zandmd/esp32-projects/eda/3d/PASSIVE-NPOL-0805.stp

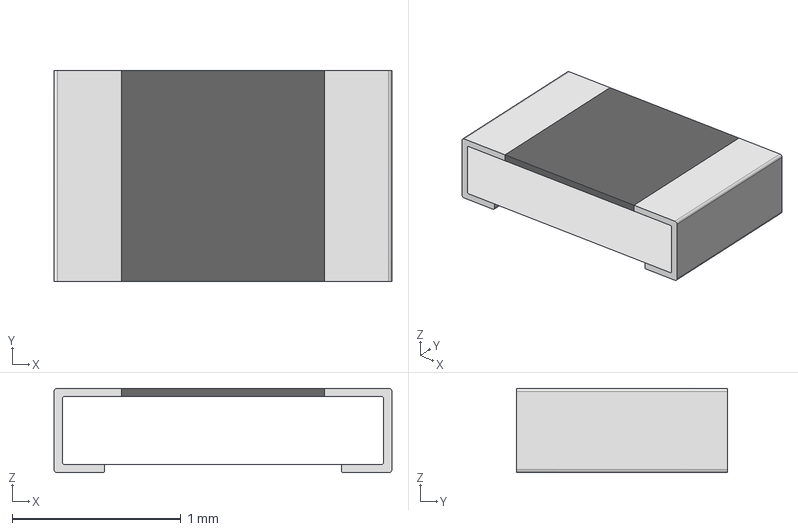
[picture p1: CAD file, 2023-10-10]
eda/3d/PASSIVE-NPOL-0805.stp
2.00 x 1.25 x 0.5 mm
