zandmd/esp32-projects/eda/3d/302-S101.step

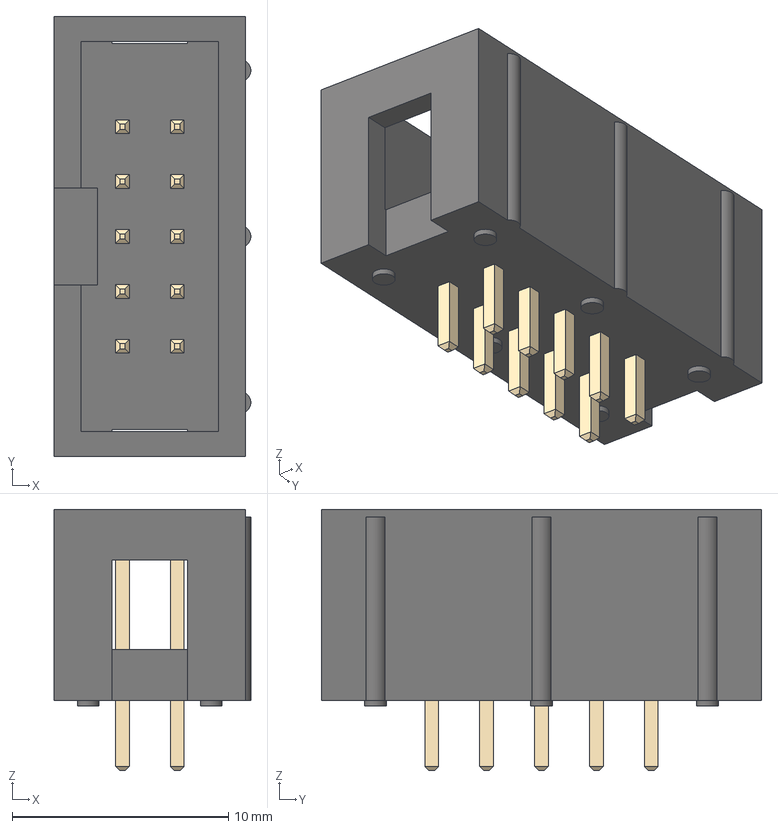
[picture p3: CAD file, 2023-10-10]
eda/3d/302-S101.step
9.10 x 20.4 x 12.1 mm
