zandmd/esp32-projects/eda/3d/3586KTR.step

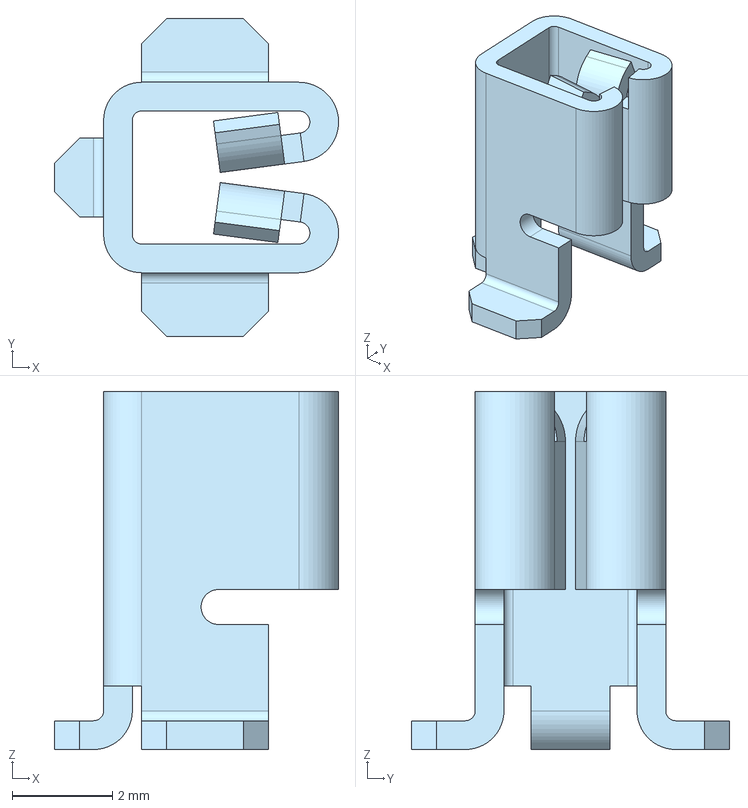
[picture p4: CAD file, 2023-10-10]
eda/3d/3586KTR.step
5.68 x 6.35 x 7.16 mm
