zandmd/esp32-projects/eda/3d/AZ1117IH-3.3TRG1.step

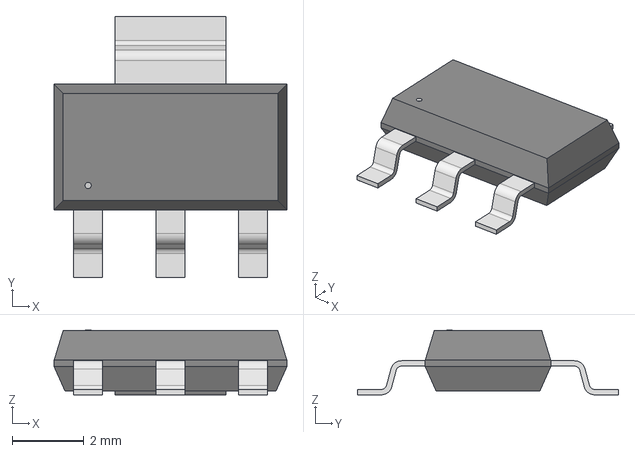
[picture p5: CAD file, 2023-10-10]
eda/3d/AZ1117IH-3.3TRG1.step
6.50 x 7.29 x 1.81 mm
