zandmd/esp32-projects/eda/3d/AZ1084CS2-3.3TRE1.step

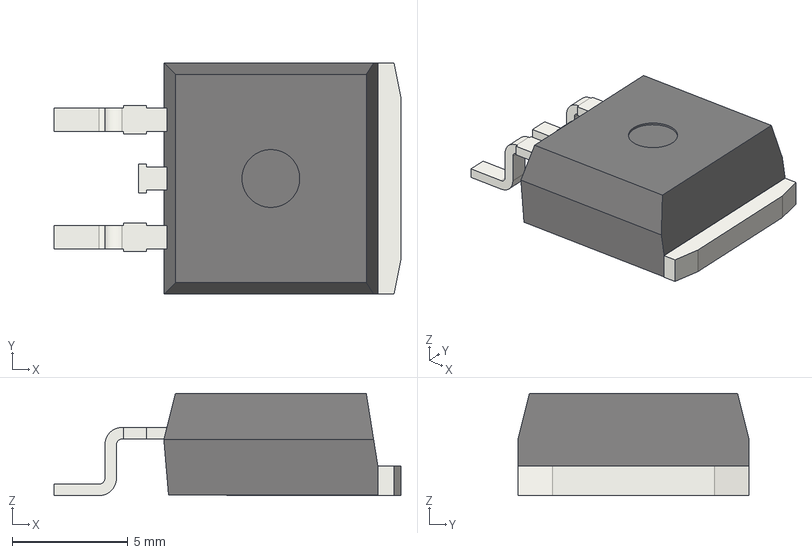
[picture p6: CAD file, 2023-10-10]
eda/3d/AZ1084CS2-3.3TRE1.step
15.0 x 10.0 x 4.42 mm
a3dd6ad7-9c39-11ed-93f0-dde97e994e83_part
a3dd6ad8-9c39-11ed-93f0-dde97e994e83_part
a3dd6ad9-9c39-11ed-93f0-dde97e994e83_part
