zandmd/esp32-projects/eda/3d/LSM6DSOTR.step

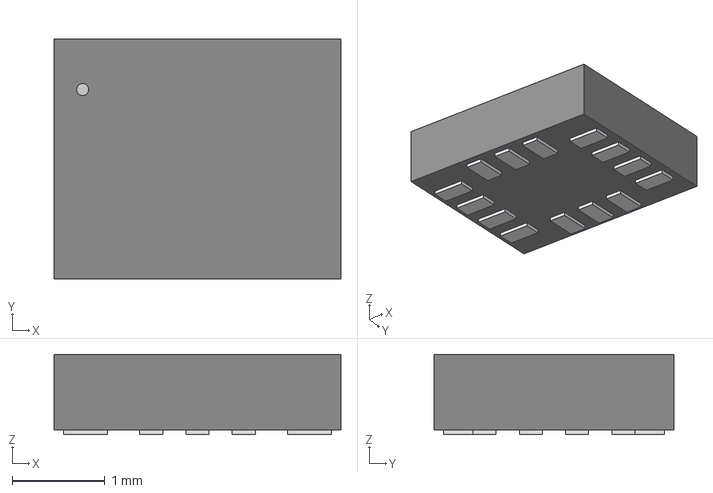
[picture p8: CAD file, 2023-10-10]
eda/3d/LSM6DSOTR.step
3.10 x 2.59 x 0.866 mm
