zandmd/esp32-projects/eda/3d/PASSIVE-NPOL-1206.stp

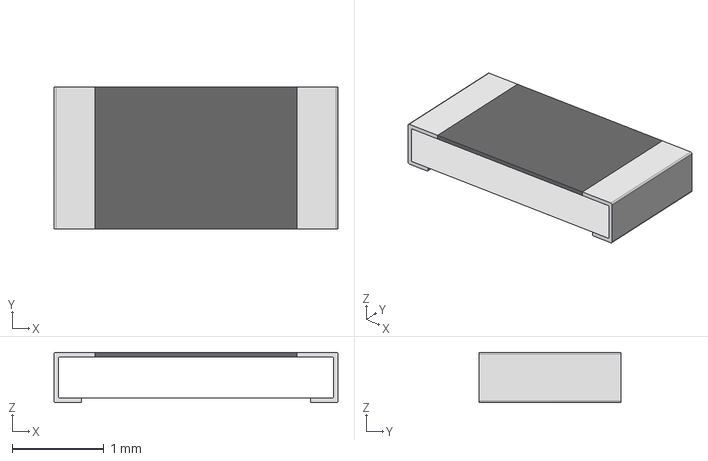
[picture p9: CAD file, 2023-10-10]
eda/3d/PASSIVE-NPOL-1206.stp
3.10 x 1.55 x 0.55 mm
