zandmd/esp32-projects/eda/3d/SMAJ5.0A.step

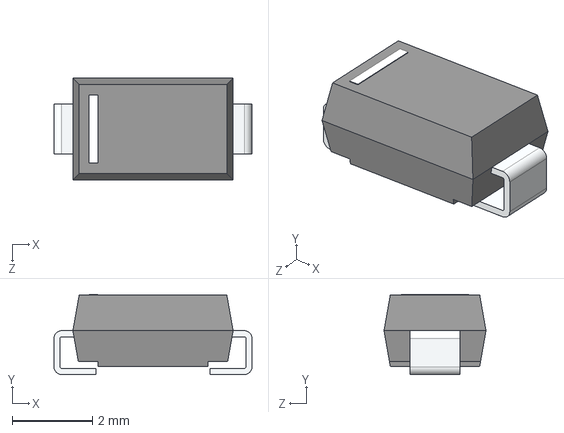
[picture p10: CAD file, 2023-10-10]
eda/3d/SMAJ5.0A.step
4.93 x 1.99 x 2.54 mm
