zandmd/esp32-projects/eda/3d/PASSIVE-POL-LED-5.7MM.stp

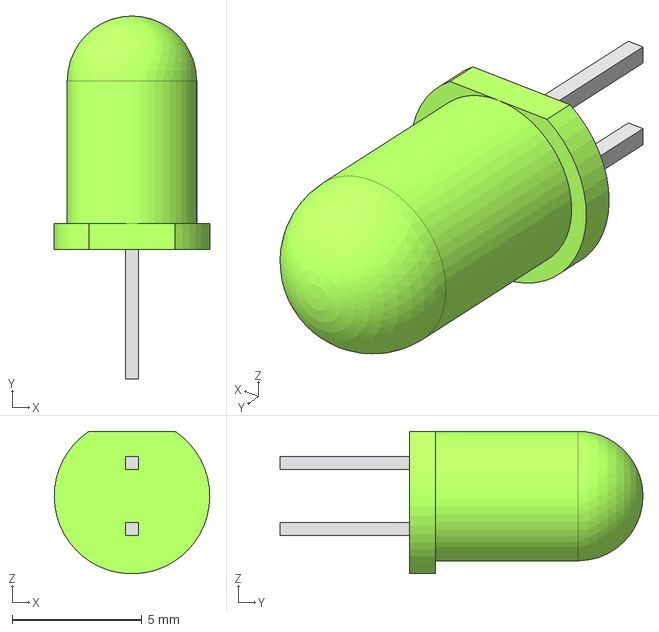
[picture p11: CAD file, 2023-10-10]
eda/3d/PASSIVE-POL-LED-5.7MM.stp
6.00 x 14.0 x 5.49 mm
