zandmd/esp32-projects/eda/3d/SHT40-BD1B-R3.STEP

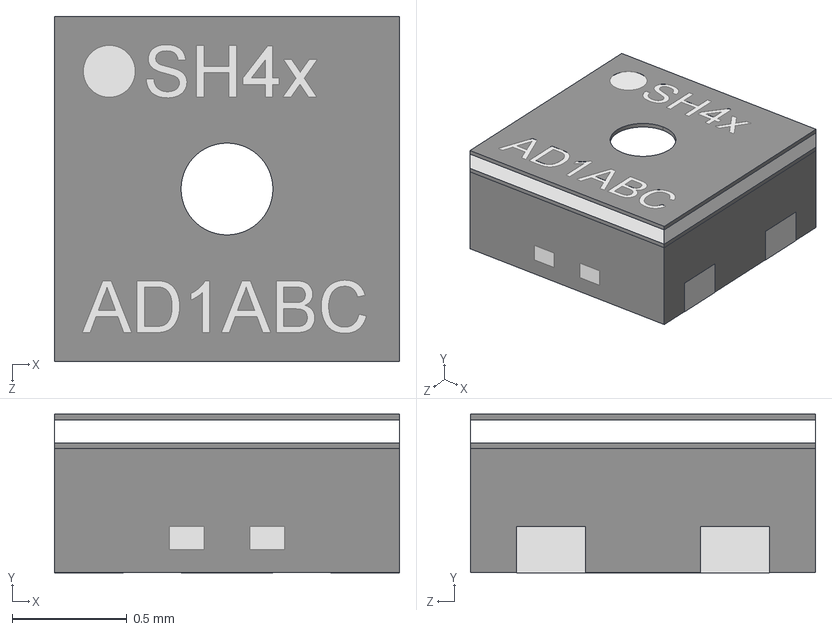
[picture p12: CAD file, 2023-10-10]
eda/3d/SHT40-BD1B-R3.STEP
1.50 x 0.691 x 1.50 mm
