zandmd/esp32-projects/eda/3d/LTV-847S.STEP

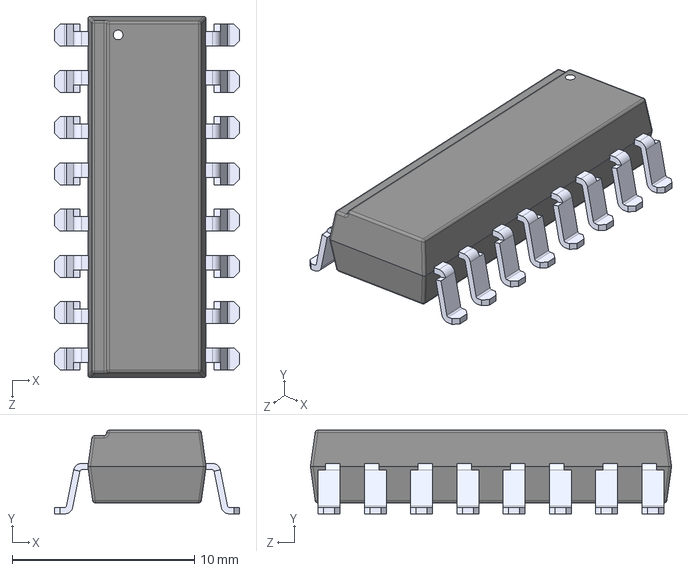
[picture p13: CAD file, 2023-10-10]
eda/3d/LTV-847S.STEP
10.2 x 4.60 x 19.8 mm
