zandmd/esp32-projects/eda/3d/PTS645SM43SMTR92 LFS.STEP

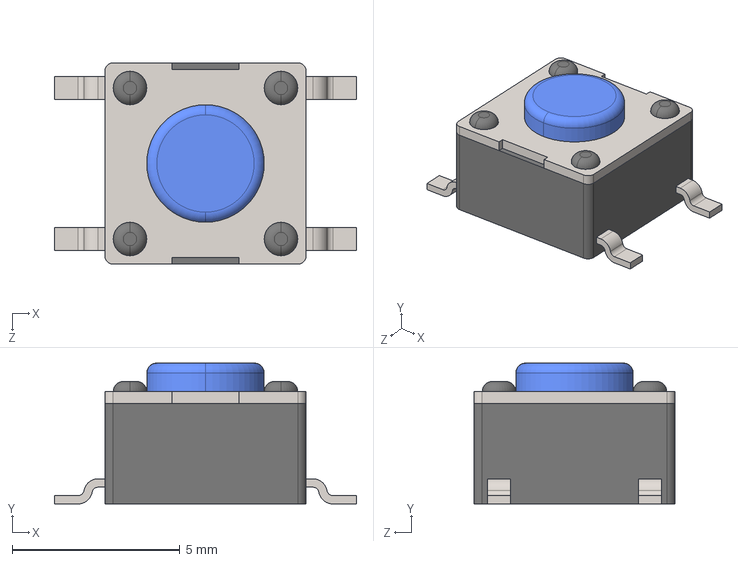
[picture p14: CAD file, 2023-10-10]
eda/3d/PTS645SM43SMTR92 LFS.STEP
9.00 x 4.20 x 6.00 mm
