zandmd/esp32-projects/eda/3d/BSS816NWH6327XTSA1.step

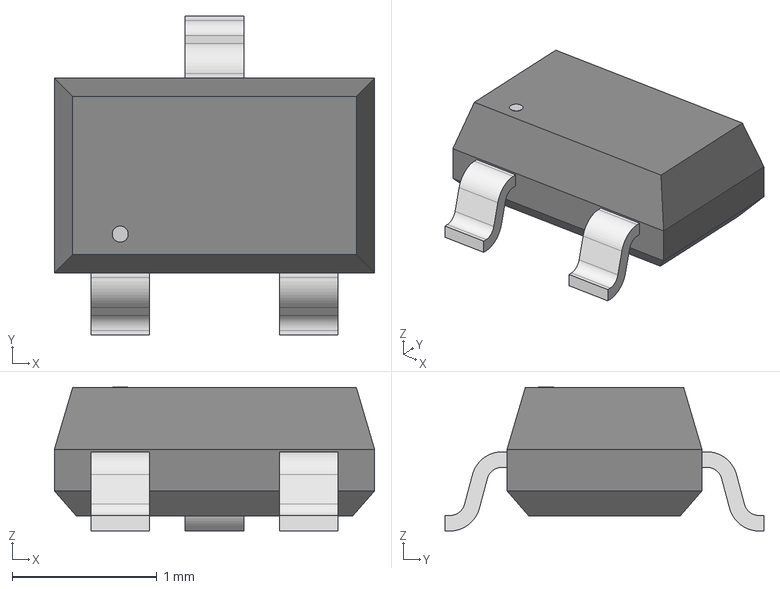
[picture p15: CAD file, 2023-10-10]
eda/3d/BSS816NWH6327XTSA1.step
2.21 x 2.20 x 0.993 mm
