zandmd/esp32-projects/eda/3d/101-106.step

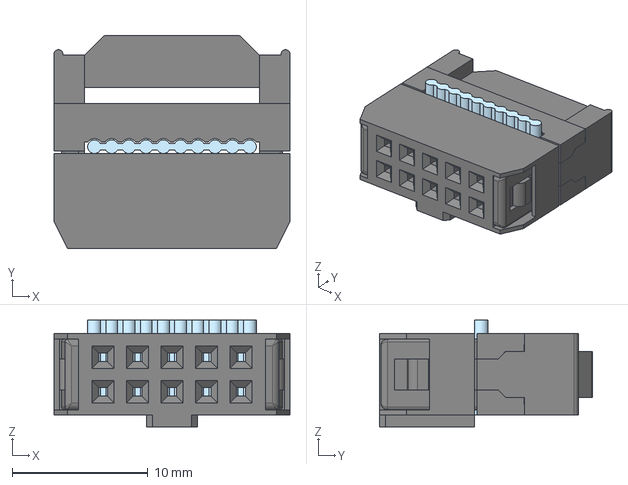
[picture p16: CAD file, 2023-10-10]
eda/3d/101-106.step
17.4 x 15.7 x 7.86 mm
