zandmd/esp32-projects/eda/3d/MB14S.STEP

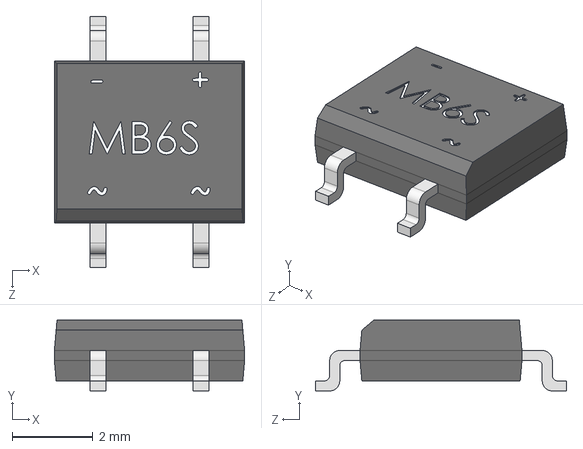
[picture p17: CAD file, 2023-10-10]
eda/3d/MB14S.STEP
4.70 x 1.75 x 6.20 mm
