zandmd/esp32-projects/eda/3d/CP2102N-A02-GQFN28.step

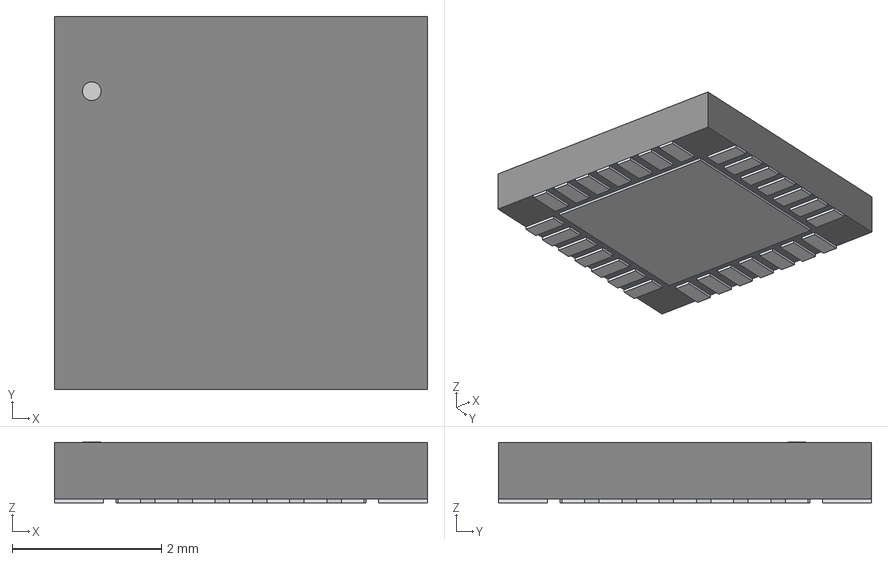
[picture p18: CAD file, 2023-10-10]
eda/3d/CP2102N-A02-GQFN28.step
5.00 x 5.00 x 0.815 mm
