zandmd/esp32-projects/eda/3d/DF3A6.8LFV,L3F.step

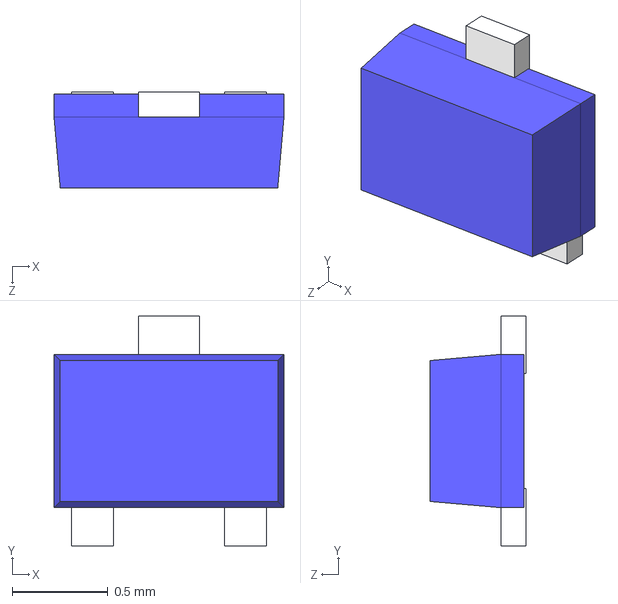
[picture p19: CAD file, 2023-10-10]
eda/3d/DF3A6.8LFV,L3F.step
1.20 x 1.20 x 0.5 mm
