zandmd/esp32-projects/eda/3d/G120N03D32.step

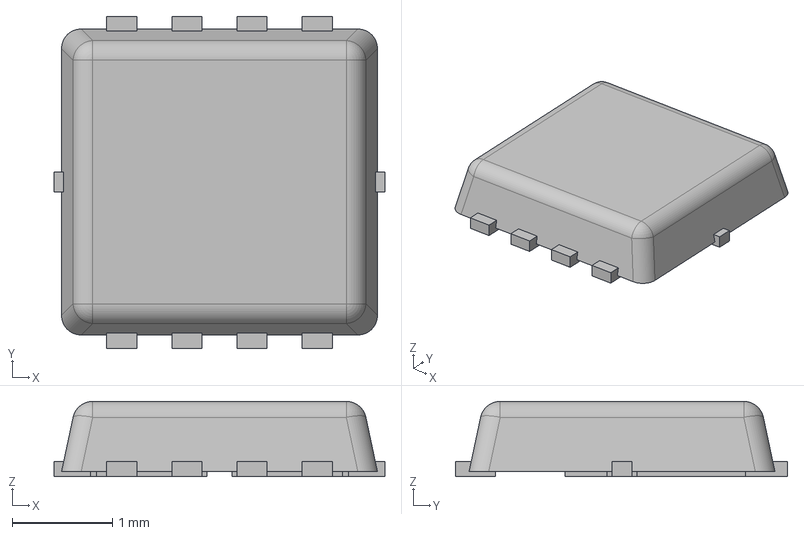
[picture p20: CAD file, 2023-10-10]
eda/3d/G120N03D32.step
3.30 x 3.31 x 0.75 mm
