zandmd/esp32-projects/eda/3d/PASSIVE-POL-LED-153283367A212.step

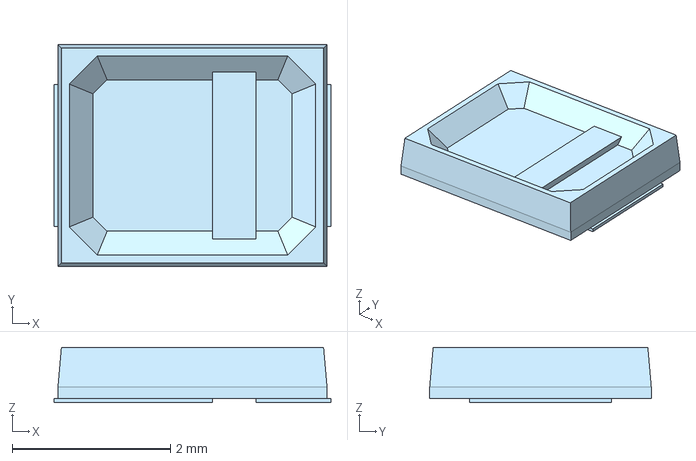
[picture p21: CAD file, 2023-10-10]
eda/3d/PASSIVE-POL-LED-153283367A212.step
3.50 x 2.80 x 0.7 mm
