zandmd/esp32-projects/eda/3d/TSOP38238.stp

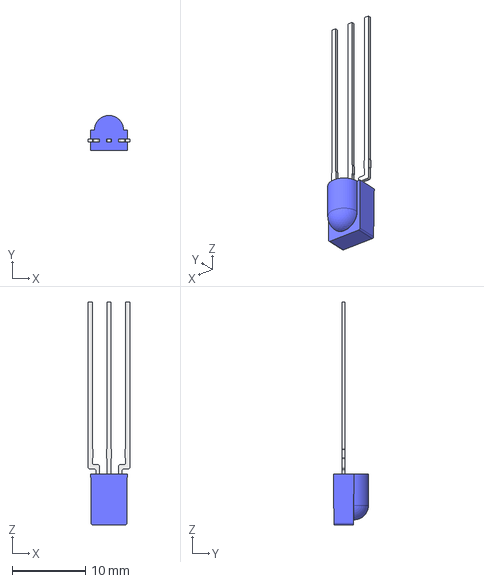
[picture p22: CAD file, 2023-10-10]
eda/3d/TSOP38238.stp
5.78 x 4.80 x 30.5 mm
GO-100187
GO-100187.01
