zandmd/esp32-projects/eda/3d/SPH0645LM4H-B.STEP

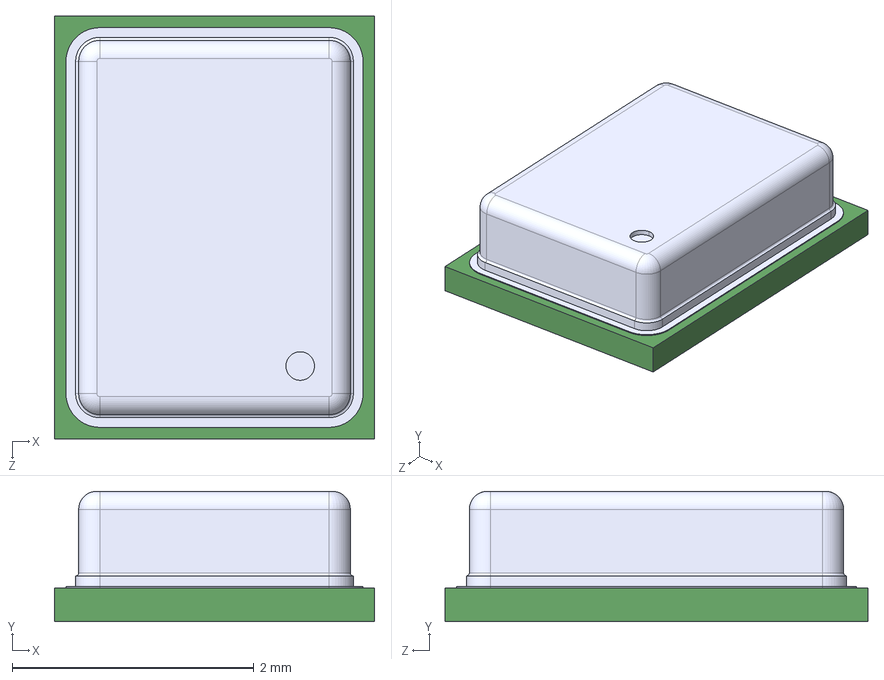
[picture p23: CAD file, 2023-10-10]
eda/3d/SPH0645LM4H-B.STEP
2.65 x 1.08 x 3.50 mm
