zandmd/esp32-projects/eda/3d/CM1293A-04SO.step

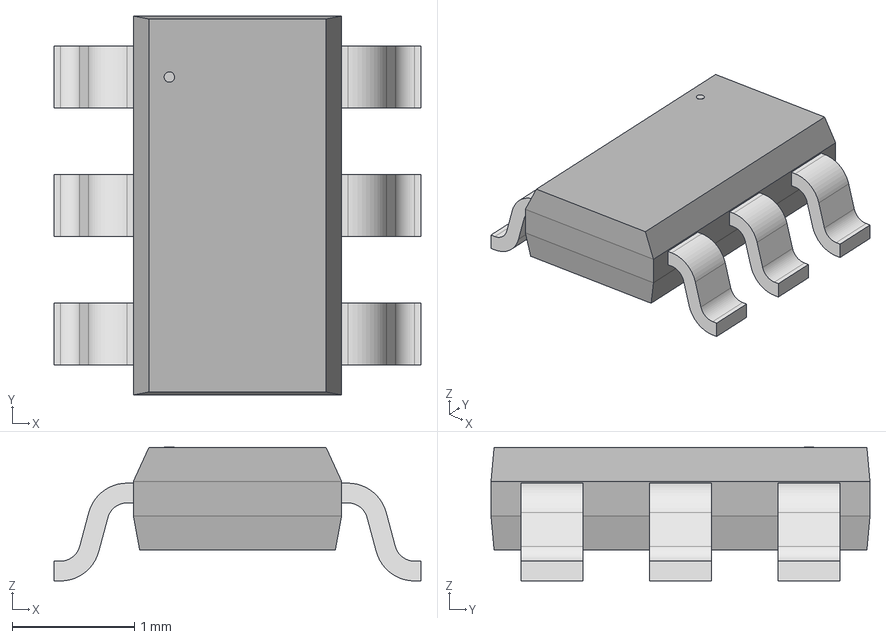
[picture p24: CAD file, 2023-10-10]
eda/3d/CM1293A-04SO.step
3.00 x 3.10 x 1.09 mm
