zandmd/esp32-projects/eda/3d/OSTVN04A150.STEP

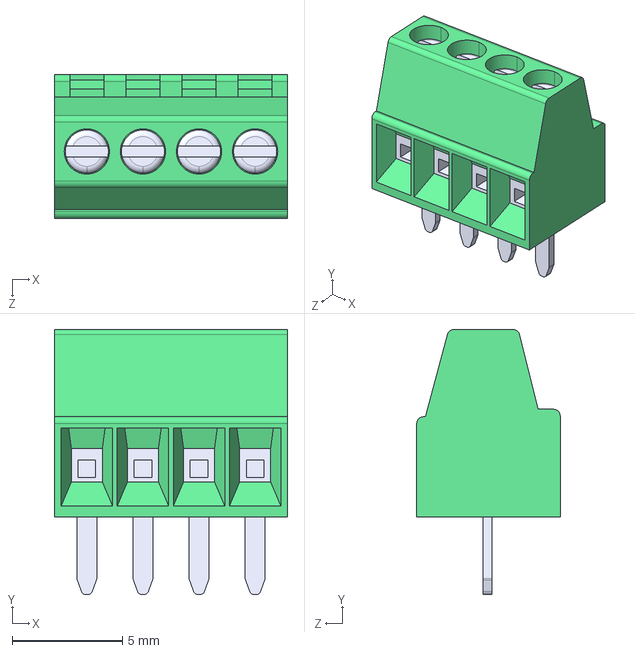
[picture p25: CAD file, 2023-10-10]
eda/3d/OSTVN04A150.STEP
10.6 x 12.0 x 6.50 mm
