zandmd/esp32-projects/eda/3d/PH1-03-UA.stp

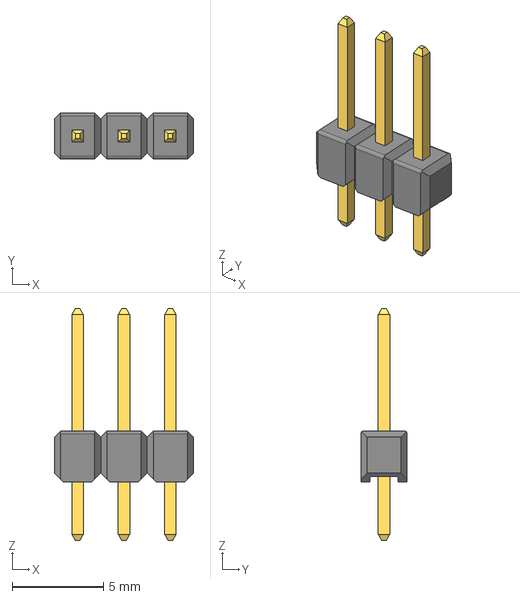
[picture p26: CAD file, 2023-10-10]
eda/3d/PH1-03-UA.stp
7.62 x 2.54 x 12.7 mm
