zandmd/esp32-projects/eda/3d/2659.STEP

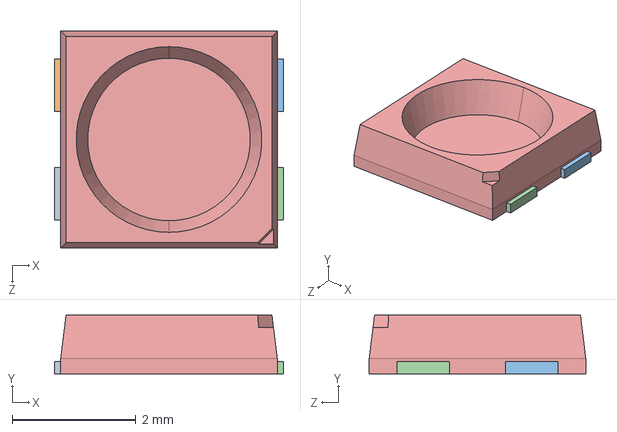
[picture p27: CAD file, 2023-10-10]
eda/3d/2659.STEP
3.70 x 0.95 x 3.50 mm
