zandmd/esp32-projects/eda/3d/AP3032KTR-G1.step

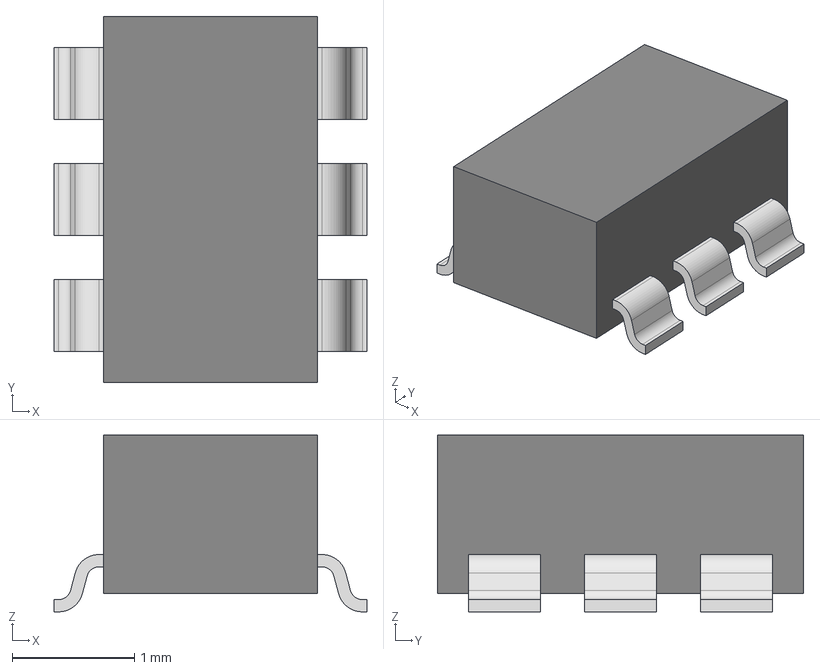
[picture p28: CAD file, 2023-10-10]
eda/3d/AP3032KTR-G1.step
2.56 x 3.00 x 1.45 mm
