zandmd/esp32-projects/eda/3d/S2B-PH-K-S.step

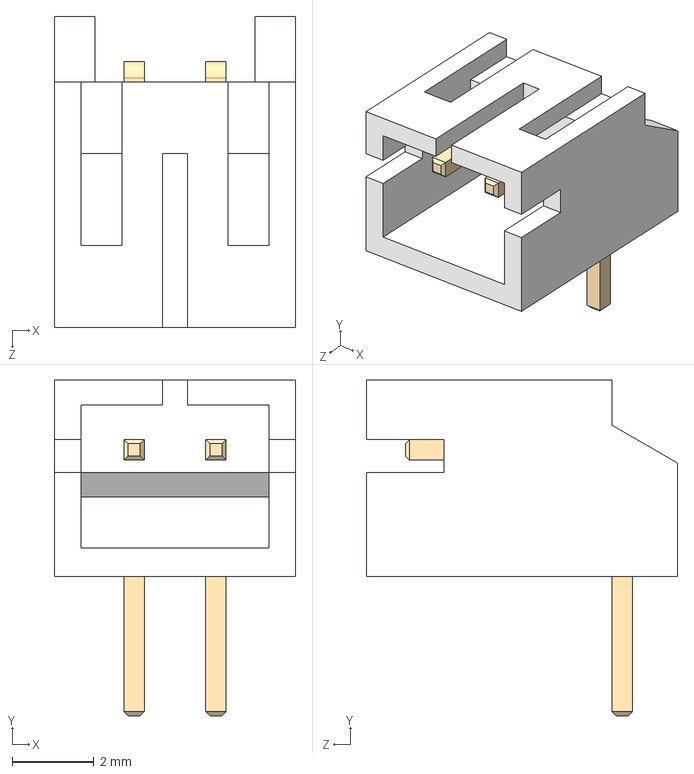
[picture p29: CAD file, 2023-10-10]
eda/3d/S2B-PH-K-S.step
5.90 x 8.20 x 7.60 mm
