zandmd/esp32-projects/(list of files, cad)

Other CAD files:
eda/3d/0297005.WXNV.step
eda/3d/2337019-1.stp
eda/3d/744232090.stp
eda/3d/824011.stp
eda/3d/CF25081D0R0-10-NH.step
eda/3d/MCP73812T-420IOT.step
eda/3d/MS563702BA03-50.stp
