zandmd/esp32-projects/eda/rocket-launcher/peripheral-board/peripheral-board.kicad_pcb

## KiCad design eda/rocket-launcher/peripheral-board/peripheral-board.kicad_pcb (2023-10-10)

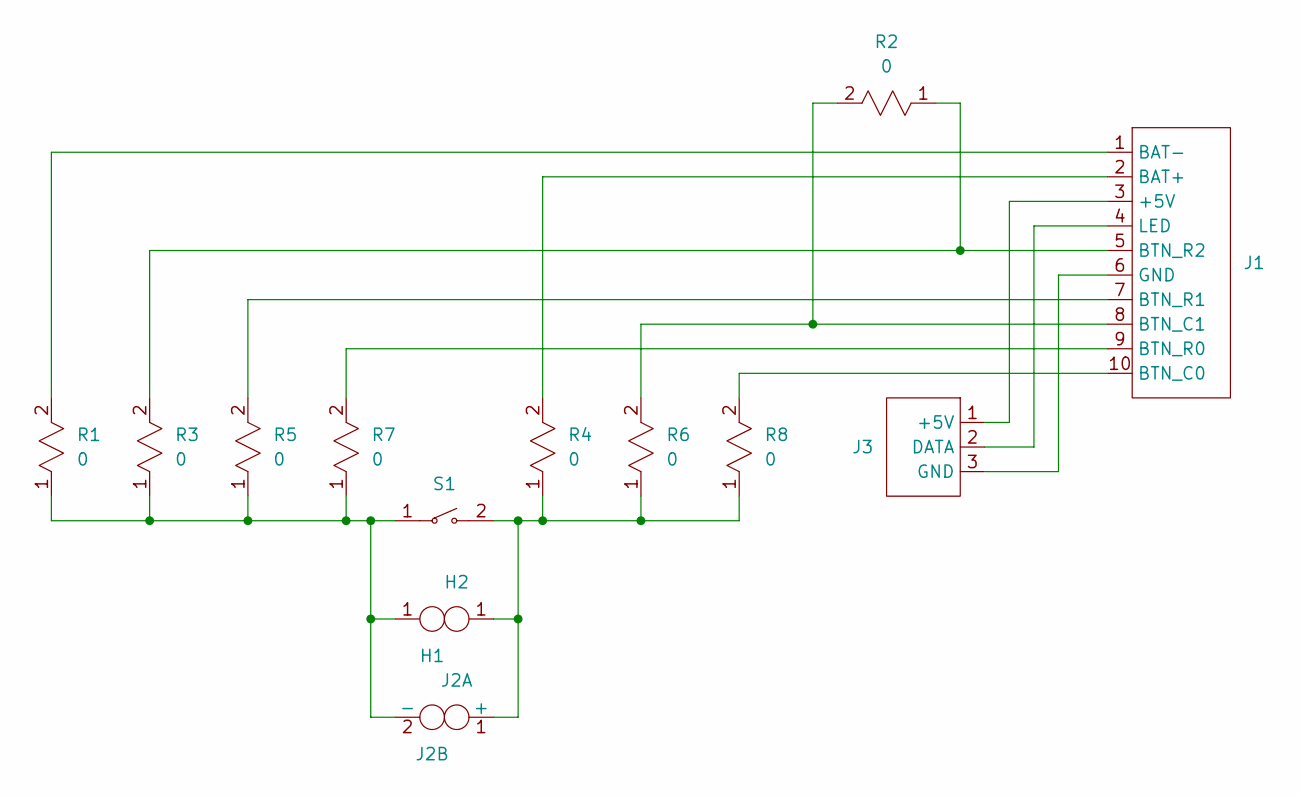
[picture p30: schematic peripheral-board.kicad_sch]

Parts:
H1, H2: B076FX76R8
J1: 302-S101
J2: B095WMQ8Y8
J3: B01AG923GI
R1, R2, R3, R4, R5, R6, R7, R8: 0; PASSIVE-NPOL-0805
S1: B07QKFD7Z7

Connections:
unnamed: J1.1 (BAT-), R1.2
unnamed: J1.2 (BAT+), R4.2
unnamed: J1.3 (+5V), J3.1 (+5V)
unnamed: J1.4 (LED), J3.2 (DATA)
unnamed: J1.5 (BTN_R2), R2.1, R3.2
unnamed: J1.6 (GND), J3.3 (GND)
unnamed: J1.7 (BTN_R1), R5.2
unnamed: J1.8 (BTN_C1), R2.2, R6.2
unnamed: J1.9 (BTN_R0), R7.2
unnamed: J1.10 (BTN_C0), R8.2
unnamed: H2.1, J2.1 (+), R4.1, R6.1, R8.1, S1.2
unnamed: H1.1, J2.2 (-), R1.1, R3.1, R5.1, R7.1, S1.1

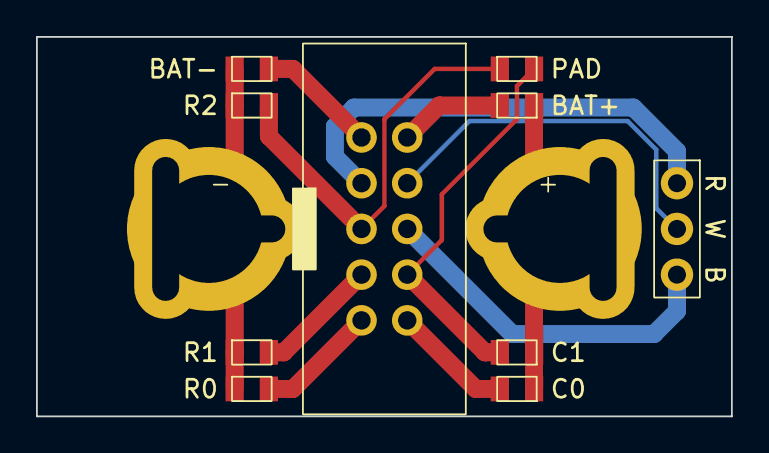
[picture p31: board peripheral-board.kicad_pcb from above]

Board: 2 copper layers, 38.6 x 21.1 mm, 14 parts (0 on the bottom side), 12 nets.
