zandmd/esp32-projects/eda/rocket-launcher/main-board/main-board.kicad_pcb

## KiCad design eda/rocket-launcher/main-board/main-board.kicad_pcb (2023-10-10)

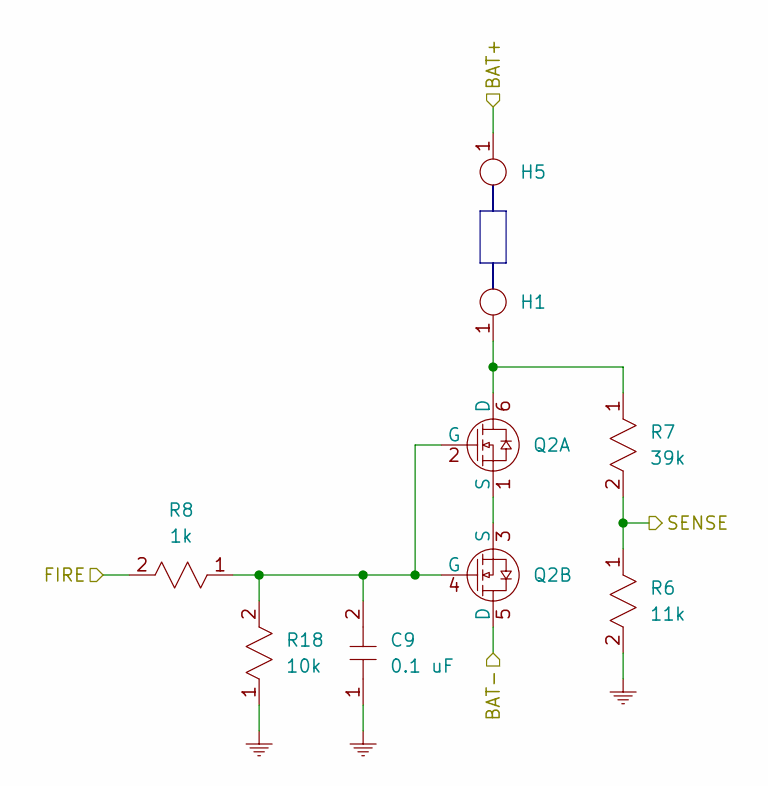
[picture p32: schematic igniter.kicad_sch]

Parts:
C9: 0.1 uF; PASSIVE-NPOL-0805
H1, H5: B076FX76R8
Q2: G120N03D32
R6: 11k; PASSIVE-NPOL-0805
R7: 39k; PASSIVE-NPOL-0805
R8: 1k; PASSIVE-NPOL-0805
R18: 10k; PASSIVE-NPOL-0805

Connections:
/+: H5.1; also elsewhere on the board
/-: Q2.5 (D); also elsewhere on the board
/Igniter0/FIRE: R8.2; also elsewhere on the board
/Igniter0/SENSE: R6.1, R7.2; also elsewhere on the board
GND: C9.1, R6.2, R18.1; also elsewhere on the board
unnamed: H1.1, Q2.6 (D), R7.1
unnamed: C9.2, Q2.2 (G), Q2.4 (G), R8.1, R18.2
unnamed: Q2.1 (S), Q2.3 (S)

Parts of its further copies:
C10, C11, C13: 0.1 uF; PASSIVE-NPOL-0805
H2, H3, H4, H6, H7, H8: B076FX76R8
Q3, Q4, Q5: G120N03D32
R9, R12, R15: 11k; PASSIVE-NPOL-0805
R10, R13, R16: 39k; PASSIVE-NPOL-0805
R11, R14, R17: 1k; PASSIVE-NPOL-0805
R19, R20, R21: 10k; PASSIVE-NPOL-0805

Connections of its further copies:
/+: H6.1, H7.1, H8.1; also elsewhere on the board
/-: Q3.5 (D), Q4.5 (D), Q5.5 (D); also elsewhere on the board
/Igniter1/FIRE: R14.2; also elsewhere on the board
/Igniter1/SENSE: R12.1, R13.2; also elsewhere on the board
/Igniter2/FIRE: R11.2; also elsewhere on the board
/Igniter2/SENSE: R9.1, R10.2; also elsewhere on the board
/Igniter3/FIRE: R17.2; also elsewhere on the board
/Igniter3/SENSE: R15.1, R16.2; also elsewhere on the board
GND: C10.1, C11.1, C13.1, R9.2, R12.2, R15.2, R19.1, R20.1, R21.1; also elsewhere on the board
unnamed: H2.1, Q3.6 (D), R10.1
unnamed: C10.2, Q3.2 (G), Q3.4 (G), R11.1, R19.2
unnamed: Q3.1 (S), Q3.3 (S)
unnamed: H3.1, Q4.6 (D), R13.1
unnamed: C11.2, Q4.2 (G), Q4.4 (G), R14.1, R20.2
unnamed: Q4.1 (S), Q4.3 (S)
unnamed: H4.1, Q5.6 (D), R16.1
unnamed: C13.2, Q5.2 (G), Q5.4 (G), R17.1, R21.2
unnamed: Q5.1 (S), Q5.3 (S)

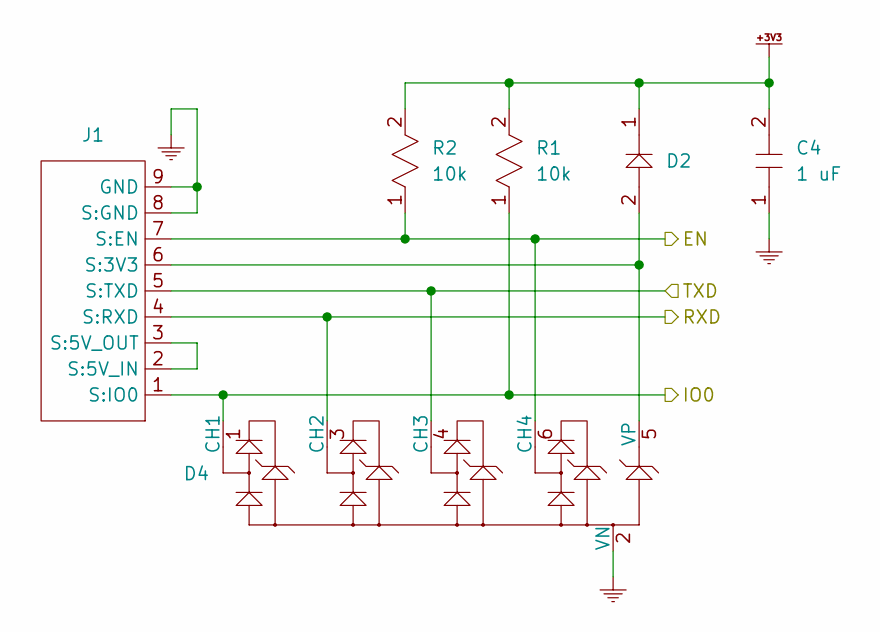
[picture p33: schematic programmer.kicad_sch]

Parts:
C4: 1 uF; PASSIVE-NPOL-0805
D2: PASSIVE-POL-0805
D4: CM1293A-04SO
J1: CF25081D0R0-10-NH
R1, R2: 10k; PASSIVE-NPOL-0805

Connections:
+3V3: C4.2, D2.1, R1.2, R2.2; also elsewhere on the board
/Microcontroller/EN: D4.6 (CH4), J1.7 (S:EN), R2.1; also elsewhere on the board
/Microcontroller/IO0: D4.1 (CH1), J1.1 (S:IO0), R1.1; also elsewhere on the board
/Microcontroller/RXD: D4.3 (CH2), J1.4 (S:RXD); also elsewhere on the board
/Microcontroller/TXD: D4.4 (CH3), J1.5 (S:TXD); also elsewhere on the board
GND: C4.1, D4.2 (VN), J1.8 (S:GND), J1.9 (GND); also elsewhere on the board
unnamed: D2.2, D4.5 (VP), J1.6 (S:3V3)
unnamed: J1.2 (S:5V_IN), J1.3 (S:5V_OUT)

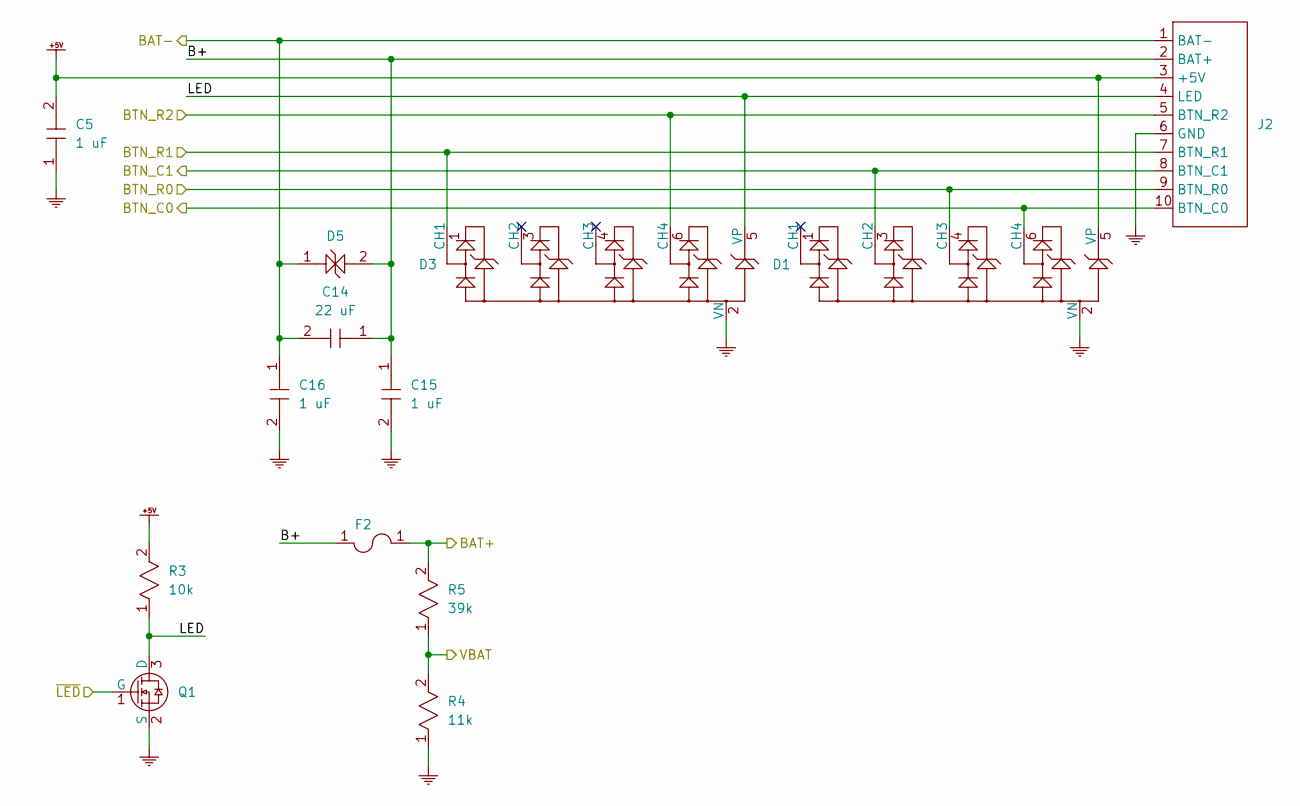
[picture p34: schematic connector.kicad_sch]

Parts:
C5, C15, C16: 1 uF; PASSIVE-NPOL-0805
C14: 22 uF; PASSIVE-NPOL-0805
D1, D3: CM1293A-04SO
D5: SMAJ15CA
F2, F3: 3586KTR
J2: 302-S101
Q1: BSS816NWH6327XTSA1
R3: 10k; PASSIVE-NPOL-0805
R4: 11k; PASSIVE-NPOL-0805
R5: 39k; PASSIVE-NPOL-0805

Connections:
+5V: C5.2, D1.5 (VP), J2.3 (+5V), R3.2; also elsewhere on the board
/+: F3.1, R5.2; also elsewhere on the board
/-: C14.2, C16.1, D5.1, J2.1 (BAT-); also elsewhere on the board
/Connector/B+: C14.1, C15.1, D5.2, F2.1, J2.2 (BAT+)
/Connector/BTN_C0: D1.6 (CH4), J2.10 (BTN_C0); also elsewhere on the board
/Connector/BTN_C1: D1.3 (CH2), J2.8 (BTN_C1); also elsewhere on the board
/Connector/BTN_R0: D1.4 (CH3), J2.9 (BTN_R0); also elsewhere on the board
/Connector/BTN_R1: D3.1 (CH1), J2.7 (BTN_R1); also elsewhere on the board
/Connector/BTN_R2: D3.6 (CH4), J2.5 (BTN_R2); also elsewhere on the board
/Connector/LED: D3.5 (VP), J2.4 (LED), Q1.3 (D), R3.1
/Connector/VBAT: R4.2, R5.1; also elsewhere on the board
/Connector/~LED: Q1.1 (G); also elsewhere on the board
GND: C5.1, C15.2, C16.2, D1.2 (VN), D3.2 (VN), J2.6 (GND), Q1.2 (S), R4.1; also elsewhere on the board

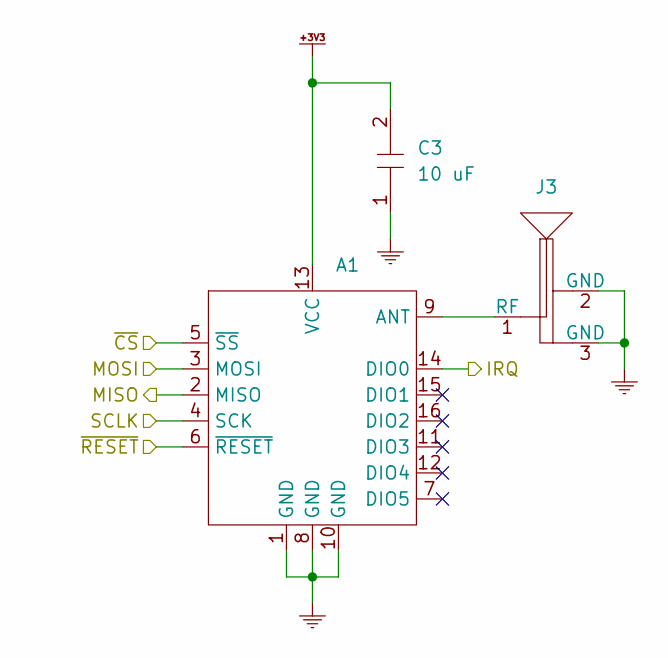
[picture p35: schematic radio.kicad_sch]

Parts:
A1: 5684
C3: 10 uF; PASSIVE-NPOL-0805
J3: 2337019-1

Connections:
+3V3: A1.13 (VCC), C3.2; also elsewhere on the board
/Microcontroller/MISO: A1.2 (MISO); also elsewhere on the board
/Microcontroller/MOSI: A1.3 (MOSI); also elsewhere on the board
/Microcontroller/RFM_IRQ: A1.14 (DIO0); also elsewhere on the board
/Microcontroller/SCLK: A1.4 (SCK); also elsewhere on the board
/Microcontroller/~CS: A1.5 (~SS); also elsewhere on the board
/Microcontroller/~RFM_RST: A1.6 (~RESET); also elsewhere on the board
GND: A1.1 (GND), A1.8 (GND), A1.10 (GND), C3.1, J3.2 (GND), J3.3 (GND); also elsewhere on the board
unnamed: A1.9 (ANT), J3.1 (RF)

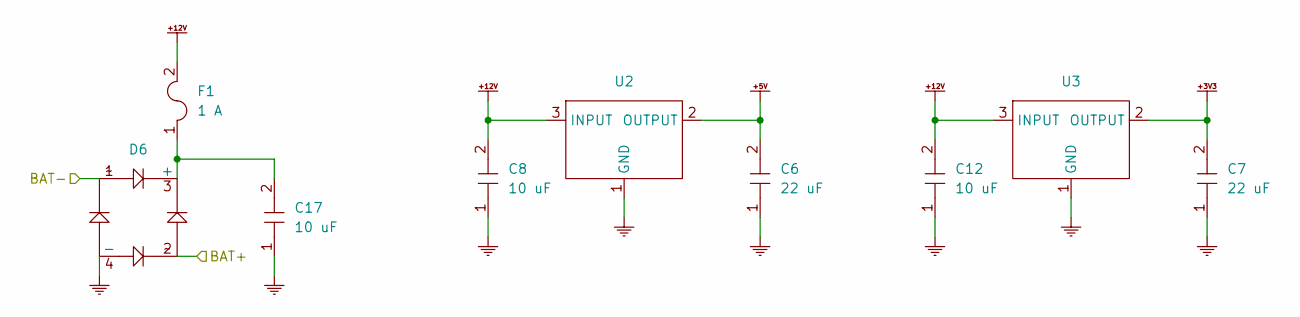
[picture p36: schematic power.kicad_sch]

Parts:
C6, C7: 22 uF; PASSIVE-NPOL-0805
C8, C12, C17: 10 uF; PASSIVE-NPOL-0805
D6: MB14S
F1: 1 A; PASSIVE-NPOL-1206
U2: AZ1117IH-5.0TRG1
U3: AZ1117IH-3.3TRG1

Connections:
+3V3: C7.2, U3.2 (OUTPUT); also elsewhere on the board
+5V: C6.2, U2.2 (OUTPUT); also elsewhere on the board
+12V: C8.2, C12.2, F1.2, U2.3 (INPUT), U3.3 (INPUT)
/+: D6.2; also elsewhere on the board
/-: D6.1; also elsewhere on the board
GND: C6.1, C7.1, C8.1, C12.1, C17.1, D6.4 (-), U2.1 (GND), U3.1 (GND); also elsewhere on the board
unnamed: C17.2, D6.3 (+), F1.1

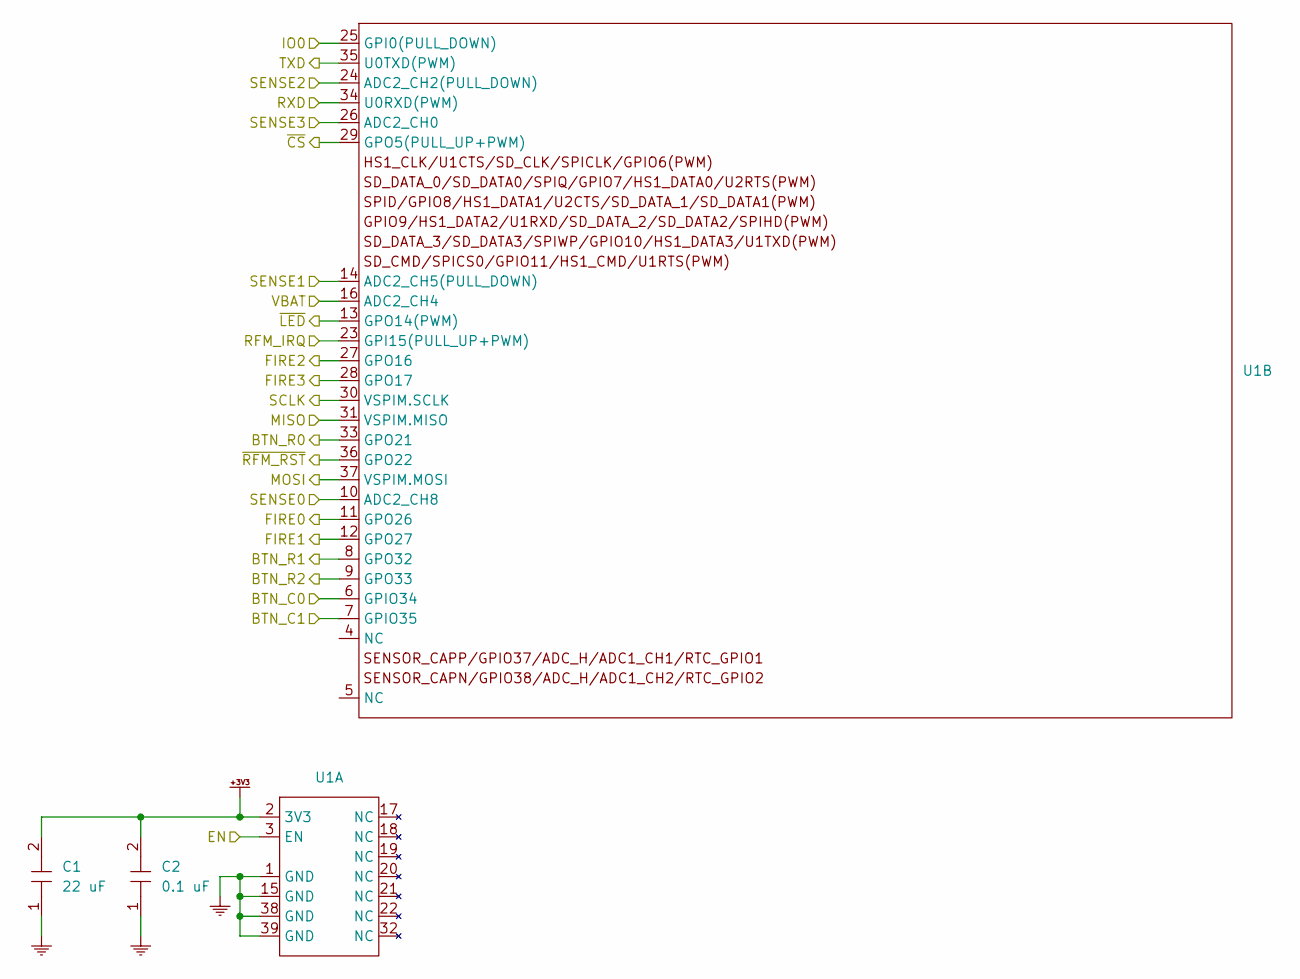
[picture p37: schematic esp32.kicad_sch]

Parts:
C1: 22 uF; PASSIVE-NPOL-0805
C2: 0.1 uF; PASSIVE-NPOL-0805
U1: ESP32-WROOM-32E-N4

Connections:
+3V3: C1.2, C2.2, U1.2 (3V3); also elsewhere on the board
/Connector/BTN_C0: U1.6 (GPIO34); also elsewhere on the board
/Connector/BTN_C1: U1.7 (GPIO35); also elsewhere on the board
/Connector/BTN_R0: U1.33 (GPO21); also elsewhere on the board
/Connector/BTN_R1: U1.8 (GPO32); also elsewhere on the board
/Connector/BTN_R2: U1.9 (GPO33); also elsewhere on the board
/Connector/VBAT: U1.16 (ADC2_CH4); also elsewhere on the board
/Connector/~LED: U1.13 (GPO14(PWM)); also elsewhere on the board
/Igniter0/FIRE: U1.11 (GPO26); also elsewhere on the board
/Igniter0/SENSE: U1.10 (ADC2_CH8); also elsewhere on the board
/Igniter1/FIRE: U1.12 (GPO27); also elsewhere on the board
/Igniter1/SENSE: U1.14 (ADC2_CH5(PULL_DOWN)); also elsewhere on the board
/Igniter2/FIRE: U1.27 (GPO16); also elsewhere on the board
/Igniter2/SENSE: U1.24 (ADC2_CH2(PULL_DOWN)); also elsewhere on the board
/Igniter3/FIRE: U1.28 (GPO17); also elsewhere on the board
/Igniter3/SENSE: U1.26 (ADC2_CH0); also elsewhere on the board
/Microcontroller/EN: U1.3 (EN); also elsewhere on the board
/Microcontroller/IO0: U1.25 (GPI0(PULL_DOWN)); also elsewhere on the board
/Microcontroller/MISO: U1.31 (VSPIM.MISO); also elsewhere on the board
/Microcontroller/MOSI: U1.37 (VSPIM.MOSI); also elsewhere on the board
/Microcontroller/RFM_IRQ: U1.23 (GPI15(PULL_UP+PWM)); also elsewhere on the board
/Microcontroller/RXD: U1.34 (U0RXD(PWM)); also elsewhere on the board
/Microcontroller/SCLK: U1.30 (VSPIM.SCLK); also elsewhere on the board
/Microcontroller/TXD: U1.35 (U0TXD(PWM)); also elsewhere on the board
/Microcontroller/~CS: U1.29 (GPO5(PULL_UP+PWM)); also elsewhere on the board
/Microcontroller/~RFM_RST: U1.36 (GPO22); also elsewhere on the board
GND: C1.1, C2.1, U1.1 (GND), U1.15 (GND), U1.38 (GND), U1.39 (GND); also elsewhere on the board

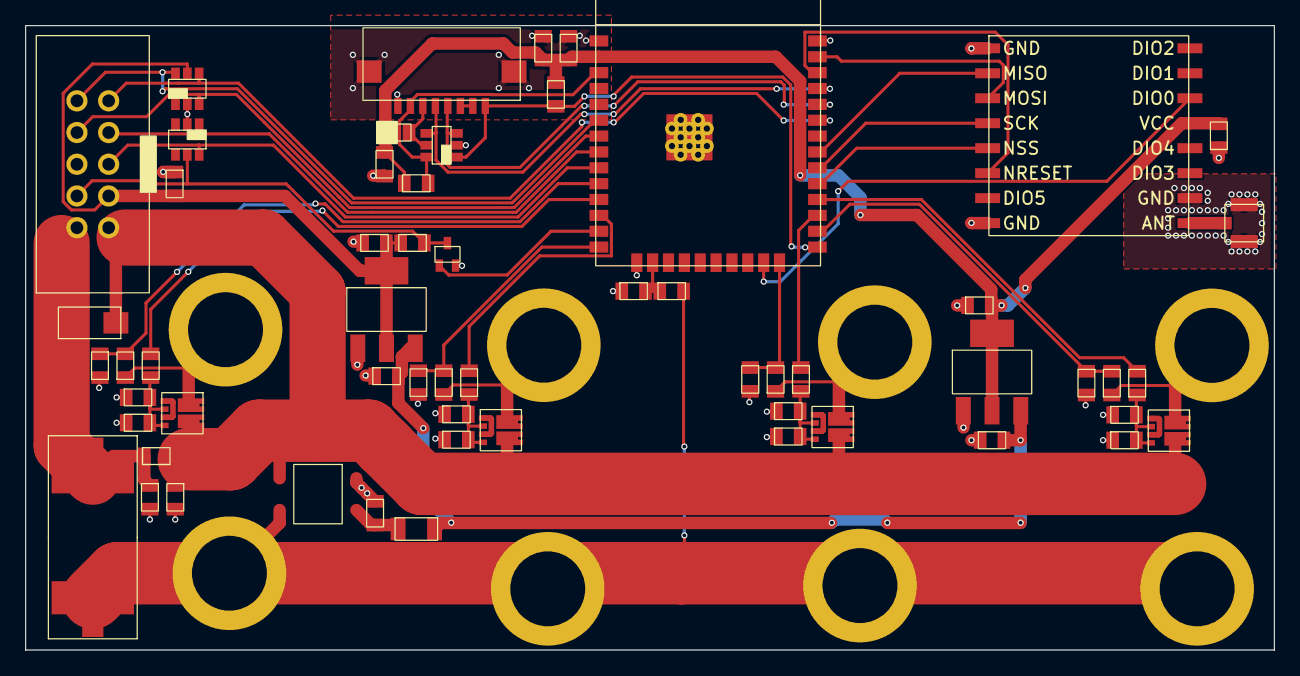
[picture p38: board main-board.kicad_pcb from above]

Board: 2 copper layers, 100.0 x 50.0 mm, 67 parts (0 on the bottom side), 49 nets.
