zandmd/esp32-projects/eda/tv-source-switcher/tv-source-switcher.kicad_pcb

## KiCad design eda/tv-source-switcher/tv-source-switcher.kicad_pcb (2023-10-10)

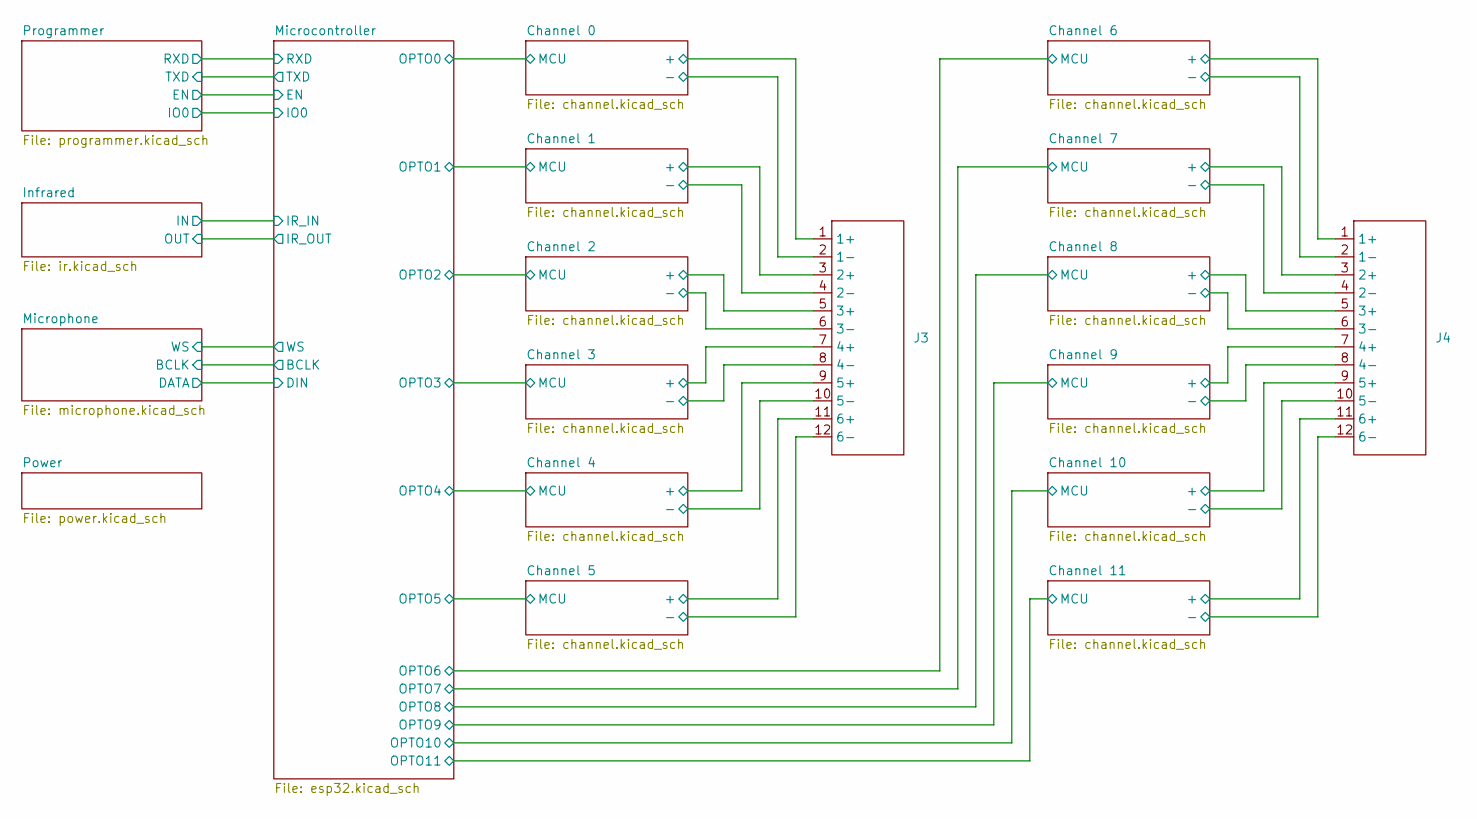
[picture p46: schematic tv-source-switcher.kicad_sch]

Parts:
J3, J4: OSTVN12A150

Connections:
/Channel 1/+: J3.3 (2+); also elsewhere on the board
/Channel 1/-: J3.4 (2-); also elsewhere on the board
/Channel 2/+: J3.5 (3+); also elsewhere on the board
/Channel 2/-: J3.6 (3-); also elsewhere on the board
/Channel 3/+: J3.7 (4+); also elsewhere on the board
/Channel 3/-: J3.8 (4-); also elsewhere on the board
/Channel 4/+: J3.9 (5+); also elsewhere on the board
/Channel 4/-: J3.10 (5-); also elsewhere on the board
/Channel 5/+: J3.11 (6+); also elsewhere on the board
/Channel 5/-: J3.12 (6-); also elsewhere on the board
/Channel 6/+: J4.1 (1+); also elsewhere on the board
/Channel 6/-: J4.2 (1-); also elsewhere on the board
/Channel 7/+: J4.3 (2+); also elsewhere on the board
/Channel 7/-: J4.4 (2-); also elsewhere on the board
/Channel 8/+: J4.5 (3+); also elsewhere on the board
/Channel 8/-: J4.6 (3-); also elsewhere on the board
/Channel 9/+: J4.7 (4+); also elsewhere on the board
/Channel 9/-: J4.8 (4-); also elsewhere on the board
/Channel 10/+: J4.9 (5+); also elsewhere on the board
/Channel 10/-: J4.10 (5-); also elsewhere on the board
