zandmd/esp32-projects/eda/tv-source-switcher/tv-source-switcher.kicad_pcb

## KiCad design eda/tv-source-switcher/tv-source-switcher.kicad_pcb (continued)

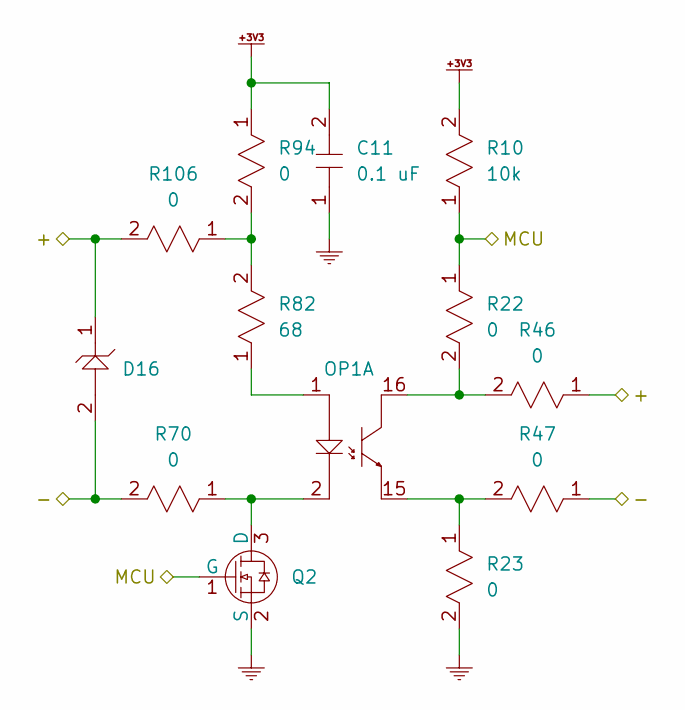
[picture p47: schematic channel.kicad_sch]

Parts:
C11: 0.1 uF; PASSIVE-NPOL-0805
D16: SMAJ5.0A
OP1: LTV-847S
Q2: BSS816NWH6327XTSA1
R10: 10k; PASSIVE-NPOL-0805
R22, R23, R46, R47, R70, R94, R106: 0; PASSIVE-NPOL-0805
R82: 68; PASSIVE-NPOL-0805

Connections:
+3V3: C11.2, R10.2, R94.1; also elsewhere on the board
/Channel 0/MCU: Q2.1 (G), R10.1, R22.1; also elsewhere on the board
GND: C11.1, Q2.2 (S), R23.2; also elsewhere on the board
unnamed: OP1.1 (A), R82.1
unnamed: OP1.16 (C), R22.2, R46.2
unnamed: OP1.15 (E), R23.1, R47.2
unnamed: OP1.2 (K), Q2.3 (D), R70.1
unnamed 52: OP1.3 (A); also elsewhere on the board
unnamed 53: OP1.14 (C); also elsewhere on the board
unnamed 54: OP1.13 (E); also elsewhere on the board
unnamed 55: OP1.4 (K); also elsewhere on the board
unnamed 56: OP1.5 (A); also elsewhere on the board
unnamed 57: OP1.12 (C); also elsewhere on the board
unnamed 58: OP1.11 (E); also elsewhere on the board
unnamed 59: OP1.6 (K); also elsewhere on the board
unnamed 60: OP1.7 (A); also elsewhere on the board
unnamed 61: OP1.10 (C); also elsewhere on the board
unnamed 62: OP1.9 (E); also elsewhere on the board
unnamed 63: OP1.8 (K); also elsewhere on the board
unnamed: R82.2, R94.2, R106.1

Parts of its further copies:
C12, C13, C14, C15, C16, C17, C18, C19, C20, C21, C22: 0.1 uF; PASSIVE-NPOL-0805
D5, D6, D7, D8, D9, D10, D11, D12, D13, D14, D15: SMAJ5.0A
OP2, OP3: LTV-847S
Q3, Q4, Q5, Q6, Q7, Q8, Q9, Q10, Q11, Q12, Q13: BSS816NWH6327XTSA1
R11, R12, R13, R14, R15, R16, R17, R18, R19, R20, R21: 10k; PASSIVE-NPOL-0805
R24, R25, R26, R27, R28, R29, R30, R31, R32, R33, R34, R35, R36, R37, R38, R39, R40, R41, R42, R43, R44, R45, R48, R49, R50, R51, R52, R53, R54, R55, R56, R57, R58, R59, R60, R61, R62, R63, R64, R65, R66, R67, R68, R69, R71, R72, R73, R74, R75, R76, R77, R78, R79, R80, R81, R95, R96, R97, R98, R99, R100, R101, R102, R103, R104, R105, R107, R108, R109, R110, R111, R112, R113, R114, R115, R116, R117: 0; PASSIVE-NPOL-0805
R83, R84, R85, R86, R87, R88, R89, R90, R91, R92, R93: 68; PASSIVE-NPOL-0805

Connections of its further copies:
+3V3: C12.2, C13.2, C14.2, C15.2, C16.2, C17.2, C18.2, C19.2, C20.2, C21.2, C22.2, R11.2, R12.2, R13.2, R14.2, R15.2, R16.2, R17.2, R18.2, R19.2, R20.2, R21.2, R95.1, R96.1, R97.1, R98.1, R99.1, R100.1, R101.1, R102.1, R103.1, R104.1, R105.1; also elsewhere on the board
/Channel 1/+: D6.1, R48.1, R107.2; also elsewhere on the board
/Channel 1/-: D6.2, R49.1, R71.2; also elsewhere on the board
/Channel 1/MCU: Q3.1 (G), R11.1, R24.1; also elsewhere on the board
/Channel 2/+: D7.1, R50.1, R108.2; also elsewhere on the board
/Channel 2/-: D7.2, R51.1, R72.2; also elsewhere on the board
/Channel 2/MCU: Q4.1 (G), R12.1, R26.1; also elsewhere on the board
/Channel 3/+: D8.1, R52.1, R109.2; also elsewhere on the board
/Channel 3/-: D8.2, R53.1, R73.2; also elsewhere on the board
/Channel 3/MCU: Q5.1 (G), R13.1, R28.1; also elsewhere on the board
/Channel 4/+: D9.1, R54.1, R110.2; also elsewhere on the board
/Channel 4/-: D9.2, R55.1, R74.2; also elsewhere on the board
/Channel 4/MCU: Q6.1 (G), R14.1, R30.1; also elsewhere on the board
/Channel 5/+: D10.1, R56.1, R111.2; also elsewhere on the board
/Channel 5/-: D10.2, R57.1, R75.2; also elsewhere on the board
/Channel 5/MCU: Q7.1 (G), R15.1, R32.1; also elsewhere on the board
/Channel 6/+: D11.1, R58.1, R112.2; also elsewhere on the board
/Channel 6/-: D11.2, R59.1, R76.2; also elsewhere on the board
/Channel 6/MCU: Q8.1 (G), R16.1, R34.1; also elsewhere on the board
/Channel 7/+: D12.1, R60.1, R113.2; also elsewhere on the board
/Channel 7/-: D12.2, R61.1, R77.2; also elsewhere on the board
/Channel 7/MCU: Q9.1 (G), R17.1, R36.1; also elsewhere on the board
/Channel 8/+: D13.1, R62.1, R114.2; also elsewhere on the board
/Channel 8/-: D13.2, R63.1, R78.2; also elsewhere on the board
/Channel 8/MCU: Q10.1 (G), R18.1, R38.1; also elsewhere on the board
/Channel 9/+: D14.1, R64.1, R115.2; also elsewhere on the board
/Channel 9/-: D14.2, R65.1, R79.2; also elsewhere on the board
/Channel 9/MCU: Q11.1 (G), R19.1, R40.1; also elsewhere on the board
/Channel 10/+: D15.1, R66.1, R116.2; also elsewhere on the board
/Channel 10/-: D15.2, R67.1, R80.2; also elsewhere on the board
/Channel 10/MCU: Q12.1 (G), R20.1, R42.1; also elsewhere on the board
/Channel 11/MCU: Q13.1 (G), R21.1, R44.1; also elsewhere on the board
GND: C12.1, C13.1, C14.1, C15.1, C16.1, C17.1, C18.1, C19.1, C20.1, C21.1, C22.1, Q3.2 (S), Q4.2 (S), Q5.2 (S), Q6.2 (S), Q7.2 (S), Q8.2 (S), Q9.2 (S), Q10.2 (S), Q11.2 (S), Q12.2 (S), Q13.2 (S), R25.2, R27.2, R29.2, R31.2, R33.2, R35.2, R37.2, R39.2, R41.2, R43.2, R45.2; also elsewhere on the board
unnamed 52: R83.1; also elsewhere on the board
unnamed 53: R24.2, R48.2; also elsewhere on the board
unnamed 54: R25.1, R49.2; also elsewhere on the board
unnamed 55: Q3.3 (D), R71.1; also elsewhere on the board
unnamed 56: R84.1; also elsewhere on the board
unnamed 57: R26.2, R50.2; also elsewhere on the board
unnamed 58: R27.1, R51.2; also elsewhere on the board
unnamed 59: Q4.3 (D), R72.1; also elsewhere on the board
unnamed 60: R85.1; also elsewhere on the board
unnamed 61: R28.2, R52.2; also elsewhere on the board
unnamed 62: R29.1, R53.2; also elsewhere on the board
unnamed 63: Q5.3 (D), R73.1; also elsewhere on the board
unnamed: OP2.1 (A), R86.1
unnamed: OP2.16 (C), R30.2, R54.2
unnamed: OP2.15 (E), R31.1, R55.2
unnamed: OP2.2 (K), Q6.3 (D), R74.1
unnamed: OP2.3 (A), R87.1
unnamed: OP2.14 (C), R32.2, R56.2
unnamed: OP2.13 (E), R33.1, R57.2
unnamed: OP2.4 (K), Q7.3 (D), R75.1
unnamed: OP2.5 (A), R88.1
unnamed: OP2.12 (C), R34.2, R58.2
unnamed: OP2.11 (E), R35.1, R59.2
unnamed: OP2.6 (K), Q8.3 (D), R76.1
unnamed: OP2.7 (A), R89.1
unnamed: OP2.10 (C), R36.2, R60.2
unnamed: OP2.9 (E), R37.1, R61.2
unnamed: OP2.8 (K), Q9.3 (D), R77.1
unnamed: OP3.1 (A), R90.1
unnamed: OP3.16 (C), R38.2, R62.2
unnamed: OP3.15 (E), R39.1, R63.2
unnamed: OP3.2 (K), Q10.3 (D), R78.1
unnamed: OP3.3 (A), R91.1
unnamed: OP3.14 (C), R40.2, R64.2
unnamed: OP3.13 (E), R41.1, R65.2
unnamed: OP3.4 (K), Q11.3 (D), R79.1
unnamed: OP3.5 (A), R92.1
unnamed: OP3.12 (C), R42.2, R66.2
unnamed: OP3.11 (E), R43.1, R67.2
unnamed: OP3.6 (K), Q12.3 (D), R80.1
unnamed: OP3.7 (A), R93.1
unnamed: OP3.10 (C), R44.2, R68.2
unnamed: OP3.9 (E), R45.1, R69.2
unnamed: OP3.8 (K), Q13.3 (D), R81.1
unnamed: R88.2, R100.2, R112.1
unnamed: R89.2, R101.2, R113.1
unnamed: R90.2, R102.2, R114.1
unnamed: R91.2, R103.2, R115.1
unnamed: R92.2, R104.2, R116.1
unnamed: R93.2, R105.2, R117.1
unnamed: R83.2, R95.2, R107.1
unnamed: R84.2, R96.2, R108.1
unnamed: R85.2, R97.2, R109.1
unnamed: R86.2, R98.2, R110.1
unnamed: R87.2, R99.2, R111.1

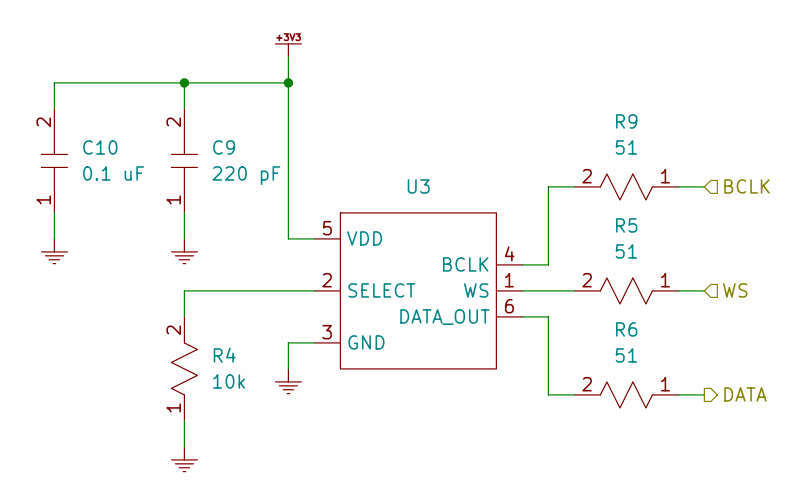
[picture p48: schematic microphone.kicad_sch]

Parts:
C9: 220 pF; PASSIVE-NPOL-0805
C10: 0.1 uF; PASSIVE-NPOL-0805
R4: 10k; PASSIVE-NPOL-0805
R5, R6, R9: 51; PASSIVE-NPOL-0805
U3: SPH0645LM4H-B

Connections:
+3V3: C9.2, C10.2, U3.5 (VDD); also elsewhere on the board
/Microcontroller/BCLK: R9.1; also elsewhere on the board
/Microcontroller/DIN: R6.1; also elsewhere on the board
/Microcontroller/WS: R5.1; also elsewhere on the board
GND: C9.1, C10.1, R4.1, U3.3 (GND); also elsewhere on the board
unnamed: R9.2, U3.4 (BCLK)
unnamed: R6.2, U3.6 (DATA_OUT)
unnamed: R4.2, U3.2 (SELECT)
unnamed: R5.2, U3.1 (WS)

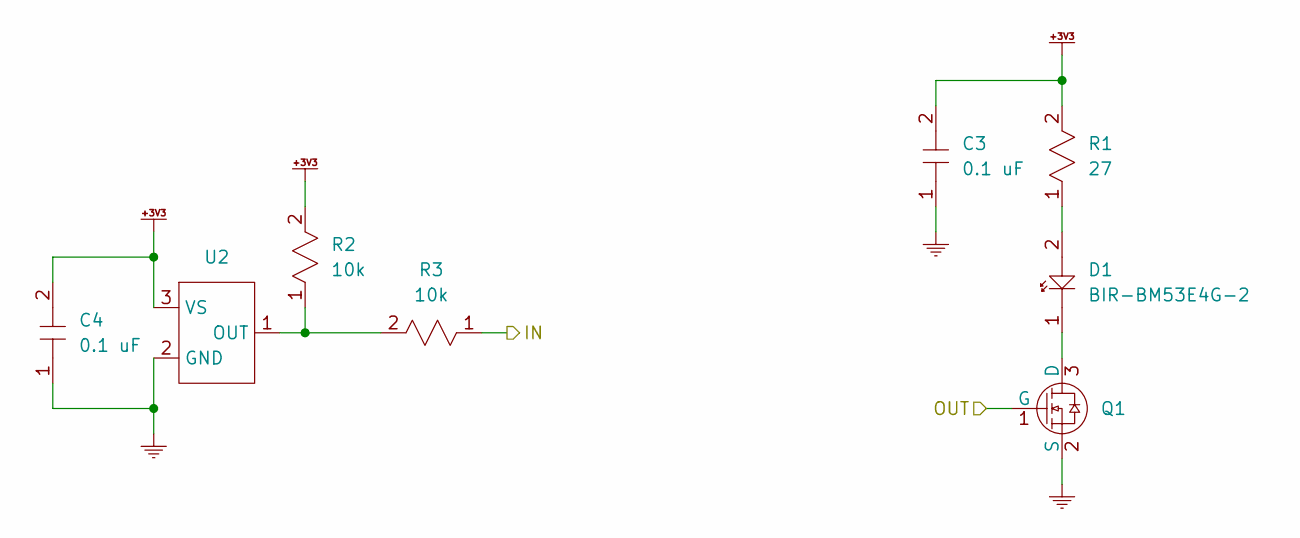
[picture p49: schematic ir.kicad_sch]

Parts:
C3, C4: 0.1 uF; PASSIVE-NPOL-0805
D1: BIR-BM53E4G-2; PASSIVE-POL-LED-5.7MM
Q1: BSS816NWH6327XTSA1
R1: 27; PASSIVE-NPOL-0805
R2, R3: 10k; PASSIVE-NPOL-0805
U2: TSOP38238

Connections:
+3V3: C3.2, C4.2, R1.2, R2.2, U2.3 (VS); also elsewhere on the board
/Infrared/IN: R3.1; also elsewhere on the board
/Infrared/OUT: Q1.1 (G); also elsewhere on the board
GND: C3.1, C4.1, Q1.2 (S), U2.2 (GND); also elsewhere on the board
unnamed: D1.2 (A), R1.1
unnamed: D1.1 (K), Q1.3 (D)
unnamed: R2.1, R3.2, U2.1 (OUT)

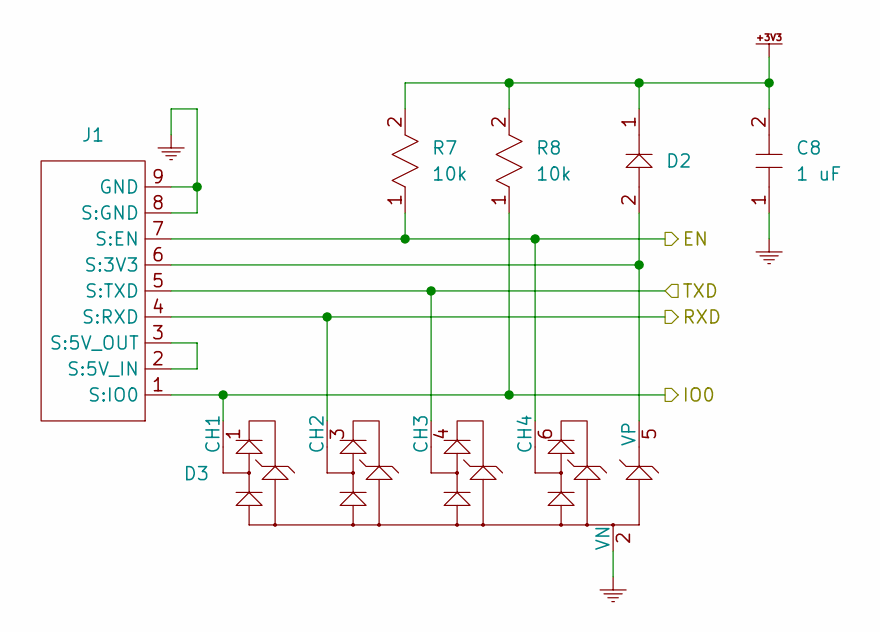
[picture p50: schematic programmer.kicad_sch]

Parts:
C8: 1 uF; PASSIVE-NPOL-0805
D2: PASSIVE-POL-0805
D3: CM1293A-04SO
J1: CF25081D0R0-10-NH
R7, R8: 10k; PASSIVE-NPOL-0805

Connections:
+3V3: C8.2, D2.1, R7.2, R8.2; also elsewhere on the board
/Microcontroller/EN: D3.6 (CH4), J1.7 (S:EN), R7.1; also elsewhere on the board
/Microcontroller/IO0: D3.1 (CH1), J1.1 (S:IO0), R8.1; also elsewhere on the board
/Microcontroller/RXD: D3.3 (CH2), J1.4 (S:RXD); also elsewhere on the board
/Microcontroller/TXD: D3.4 (CH3), J1.5 (S:TXD); also elsewhere on the board
GND: C8.1, D3.2 (VN), J1.8 (S:GND), J1.9 (GND); also elsewhere on the board
unnamed: D2.2, D3.5 (VP), J1.6 (S:3V3)
unnamed: J1.2 (S:5V_IN), J1.3 (S:5V_OUT)

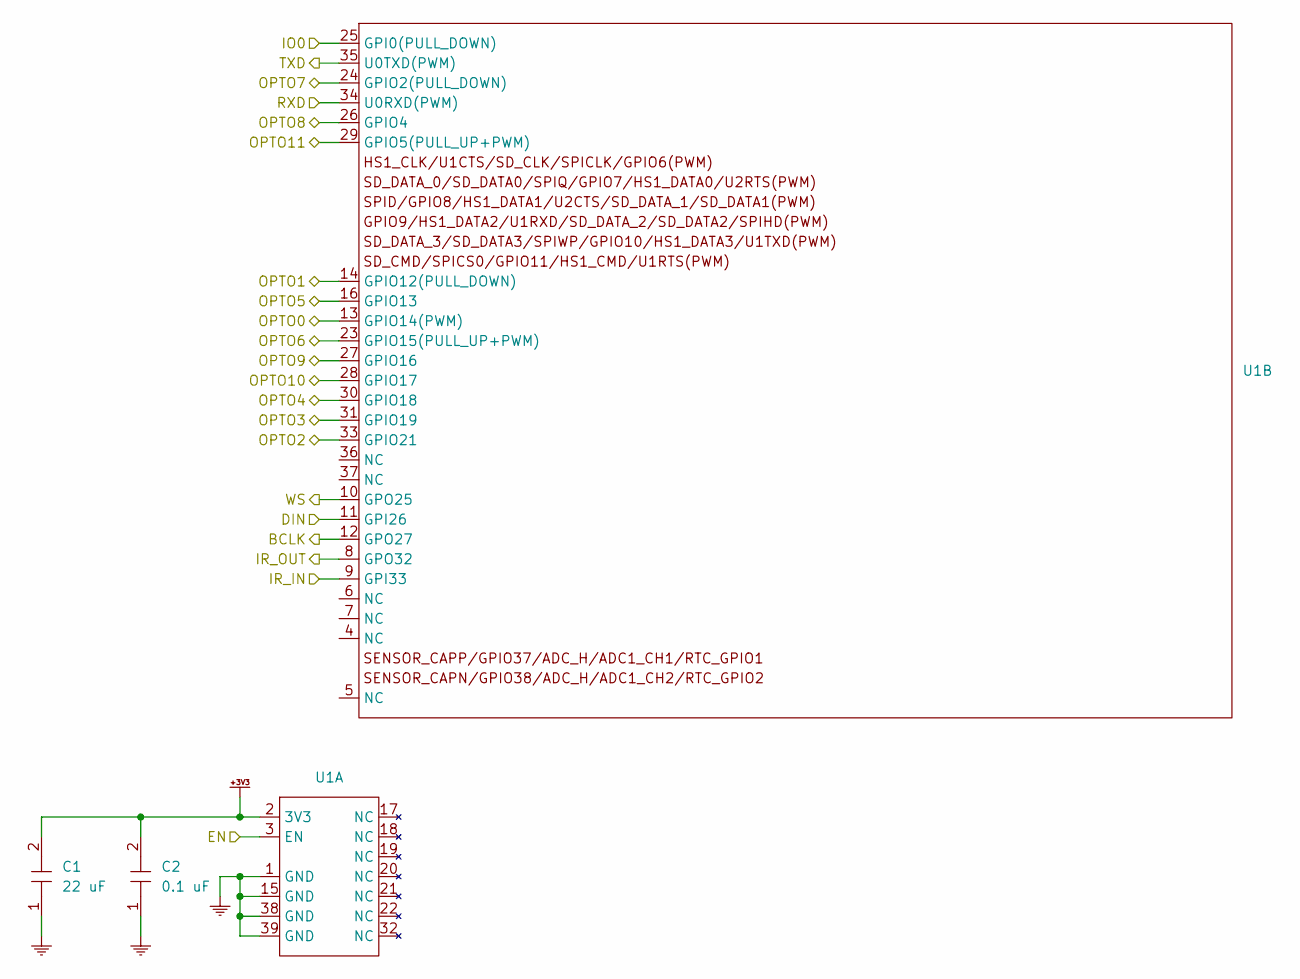
[picture p51: schematic esp32.kicad_sch]

Parts:
C1: 22 uF; PASSIVE-NPOL-0805
C2: 0.1 uF; PASSIVE-NPOL-0805
U1: ESP32-WROOM-32E-N4

Connections:
+3V3: C1.2, C2.2, U1.2 (3V3); also elsewhere on the board
/Channel 0/MCU: U1.13 (GPIO14(PWM)); also elsewhere on the board
/Channel 1/MCU: U1.14 (GPIO12(PULL_DOWN)); also elsewhere on the board
/Channel 2/MCU: U1.33 (GPIO21); also elsewhere on the board
/Channel 3/MCU: U1.31 (GPIO19); also elsewhere on the board
/Channel 4/MCU: U1.30 (GPIO18); also elsewhere on the board
/Channel 5/MCU: U1.16 (GPIO13); also elsewhere on the board
/Channel 6/MCU: U1.23 (GPIO15(PULL_UP+PWM)); also elsewhere on the board
/Channel 7/MCU: U1.24 (GPIO2(PULL_DOWN)); also elsewhere on the board
/Channel 8/MCU: U1.26 (GPIO4); also elsewhere on the board
/Channel 9/MCU: U1.27 (GPIO16); also elsewhere on the board
/Channel 10/MCU: U1.28 (GPIO17); also elsewhere on the board
/Channel 11/MCU: U1.29 (GPIO5(PULL_UP+PWM)); also elsewhere on the board
/Infrared/IN: U1.9 (GPI33); also elsewhere on the board
/Infrared/OUT: U1.8 (GPO32); also elsewhere on the board
/Microcontroller/BCLK: U1.12 (GPO27); also elsewhere on the board
/Microcontroller/DIN: U1.11 (GPI26); also elsewhere on the board
/Microcontroller/EN: U1.3 (EN); also elsewhere on the board
/Microcontroller/IO0: U1.25 (GPI0(PULL_DOWN)); also elsewhere on the board
/Microcontroller/RXD: U1.34 (U0RXD(PWM)); also elsewhere on the board
/Microcontroller/TXD: U1.35 (U0TXD(PWM)); also elsewhere on the board
/Microcontroller/WS: U1.10 (GPO25); also elsewhere on the board
GND: C1.1, C2.1, U1.1 (GND), U1.15 (GND), U1.38 (GND), U1.39 (GND); also elsewhere on the board

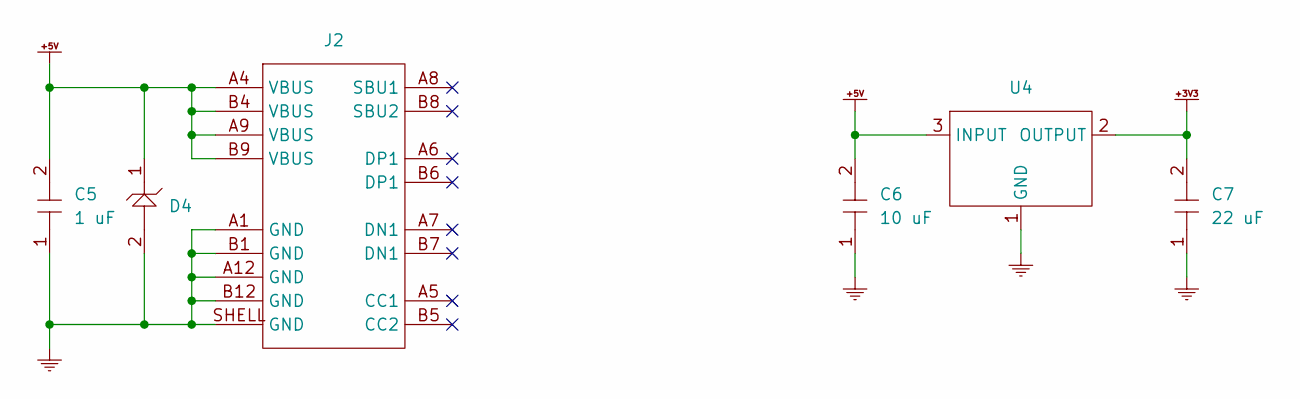
[picture p52: schematic power.kicad_sch]

Parts:
C5: 1 uF; PASSIVE-NPOL-0805
C6: 10 uF; PASSIVE-NPOL-0805
C7: 22 uF; PASSIVE-NPOL-0805
D4: SMAJ5.0A
J2: USB4520-03-0-A
U4: AZ1117IH-3.3TRG1

Connections:
+3V3: C7.2, U4.2 (OUTPUT); also elsewhere on the board
+5V: C5.2, C6.2, D4.1, J2.A4 (VBUS), J2.A9 (VBUS), J2.B4 (VBUS), J2.B9 (VBUS), U4.3 (INPUT)
GND: C5.1, C6.1, C7.1, D4.2, J2.A1 (GND), J2.A12 (GND), J2.B1 (GND), J2.B12 (GND), J2.SHELL (GND), U4.1 (GND); also elsewhere on the board

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
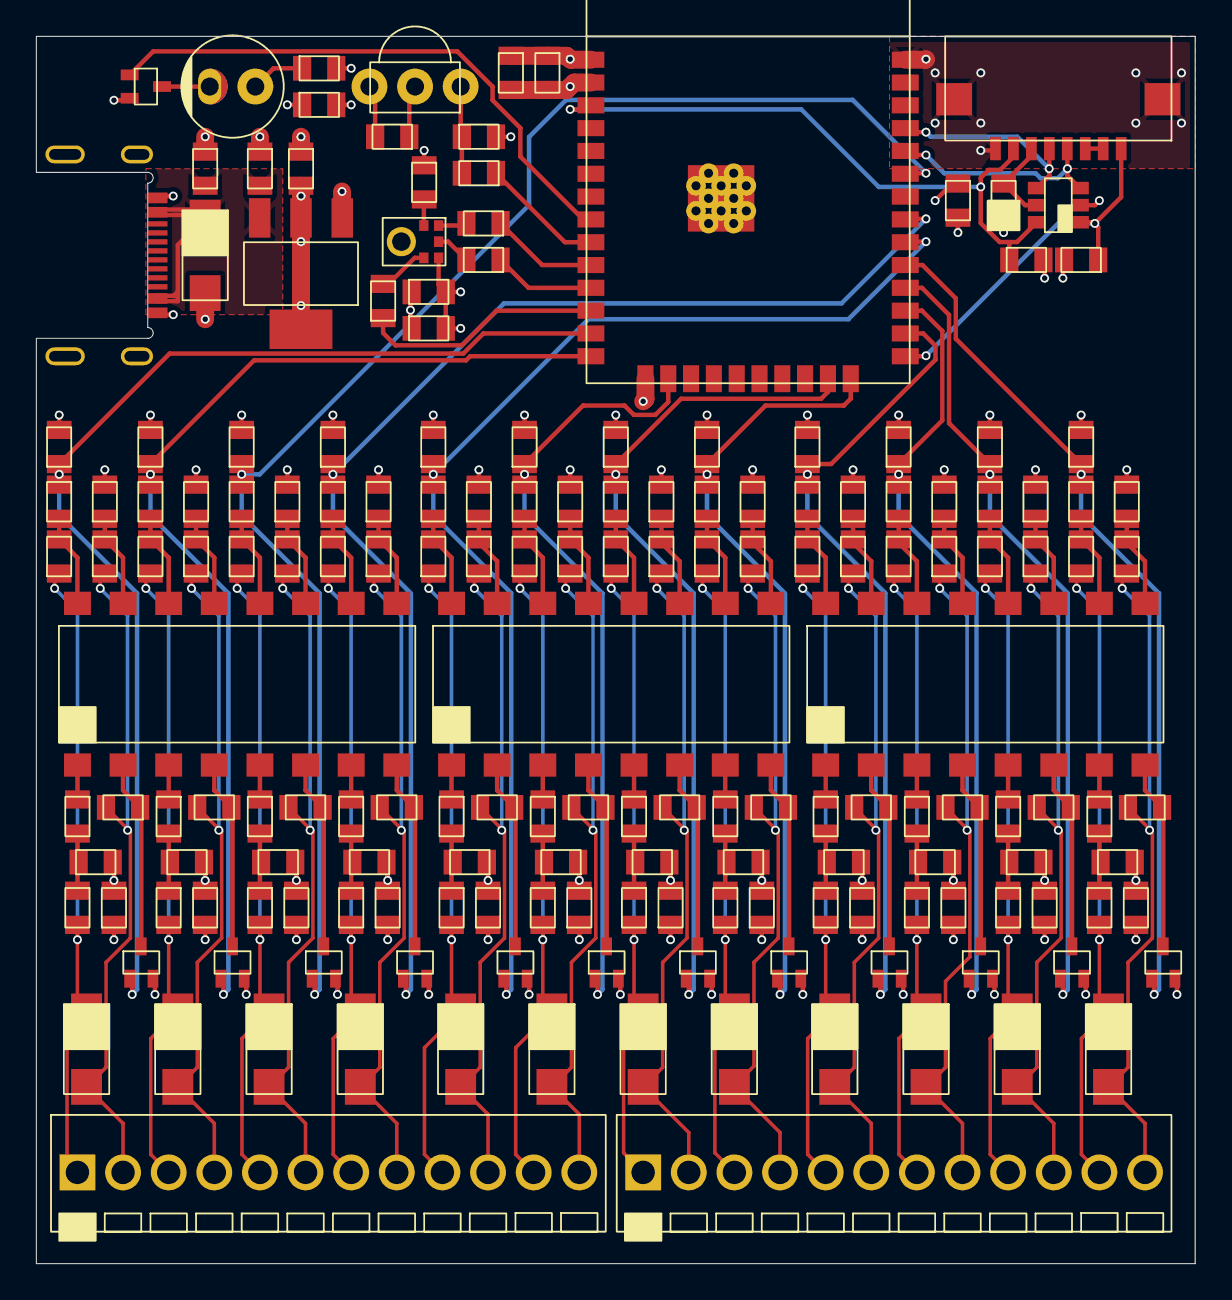
[picture p53: board tv-source-switcher.kicad_pcb from above]

Board: 4 copper layers, 64.5 x 68.3 mm, 179 parts (0 on the bottom side), 117 nets.
