zandmd/esp32-projects/eda/disc-charger/disc-charger.kicad_pcb

## KiCad design eda/disc-charger/disc-charger.kicad_pcb (2023-10-10)

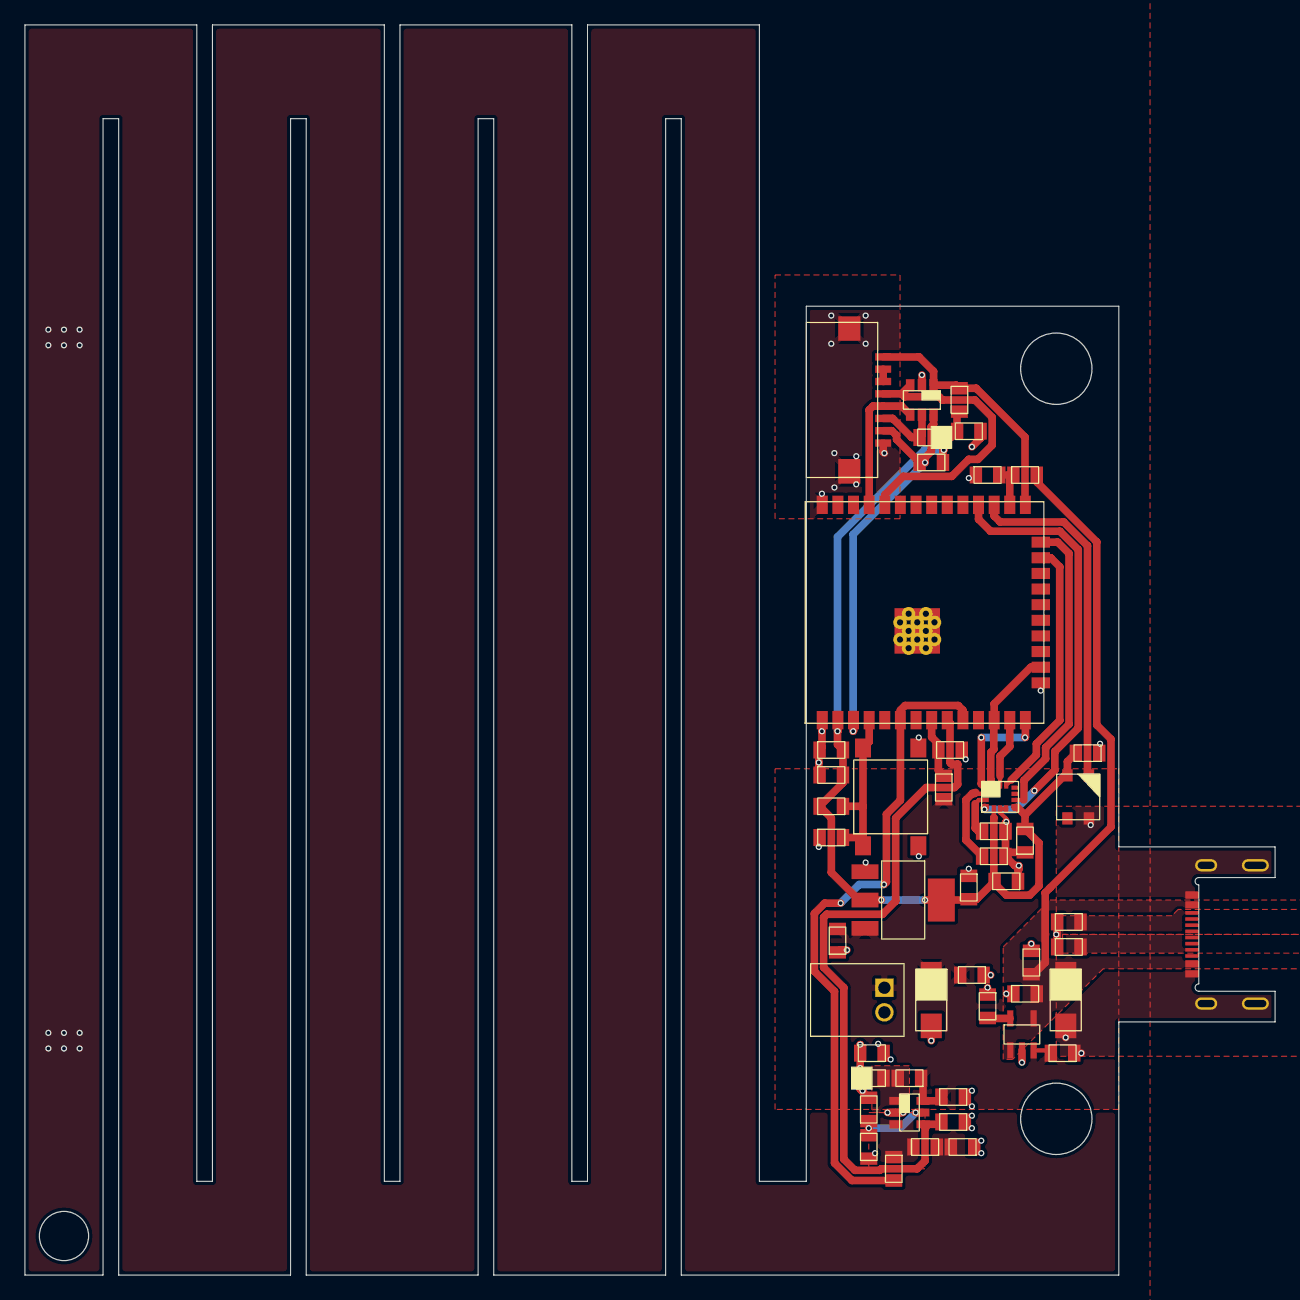
[picture p54: board disc-charger.kicad_pcb from above]

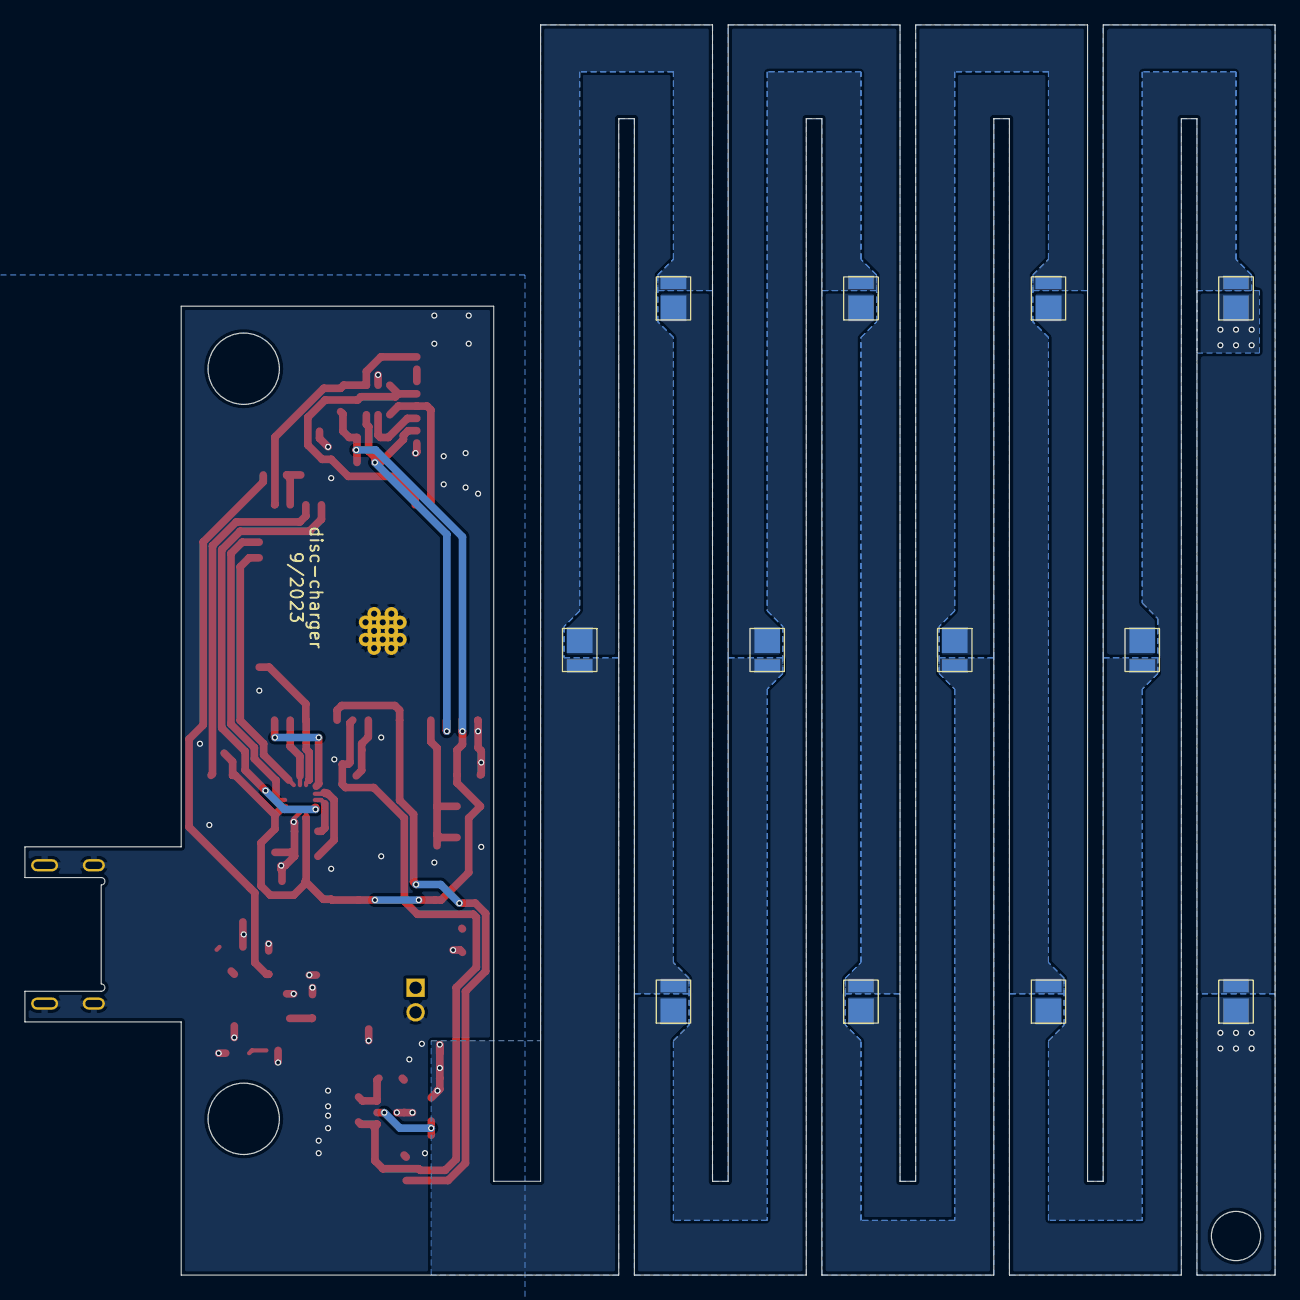
[picture p55: board disc-charger.kicad_pcb from below]

Board: 2 copper layers, 101.6 x 101.6 mm, 61 parts (12 on the bottom side), 42 nets.

Parts:
C1, C10, C11, C12, C13, C14: 1 uF; PASSIVE-NPOL-0805
C2, C3, C5, C6, C7: 0.1 uF; PASSIVE-NPOL-0805
C4, C8: 22 uF; PASSIVE-NPOL-0805
C9, C15: 10 uF; PASSIVE-NPOL-0805
D1: CM1293A-04SO
D2, D5: PASSIVE-POL-0805
D3, D4: SMAJ5.0A
D6, D7, D8, D9, D10, D11, D12, D13, D14, D15, D16, D17: 153283367A212; PASSIVE-POL-LED-153283367A212
J1: CF25081D0R0-10-NH
J2: USB4520-03-0-A
J3: S2B-PH-K-S
L1: 6.8 uH; PASSIVE-NPOL-0805
R1, R2, R3, R5, R7, R8, R9: 10k; PASSIVE-NPOL-0805
R4, R6, R10, R11, R16: 5.1k; PASSIVE-NPOL-0805
R12: 2.7k; PASSIVE-NPOL-0805
R13: 0; PASSIVE-NPOL-0805
R14, R18: 100k; PASSIVE-NPOL-0805
R15: R; PASSIVE-NPOL-0805
R17: 3.6; PASSIVE-NPOL-0805
S1: PTS645SM43SMTR92 LFS
U1: ESP32-WROOM-32E-N4
U2: LSM6DSOTR
U3: 2659
U4: AZ1117IH-3.3TRG1
U5: MCP73812T-420I/OT; MCP73812T-420IOT
U6: AP3032KTR-G1

Connections:
+3V3: C1.2, C2.2, C3.2, C4.2, C6.2, C7.2, C8.2, D2.1, R1.2, R2.2, R7.2, U1.2 (3V3), U2.5 (VDDIO), U2.8 (VDD), U3.4 (VDD), U4.2 (OUTPUT)
+5V: C10.2, C12.2, D4.1, J2.A4 (VBUS), J2.A9 (VBUS), J2.B4 (VBUS), J2.B9 (VBUS), R4.2, U5.1 (CE), U5.4 (VDD)
/LEDs/CTRL: R14.2, U1.9 (GPO33), U6.4 (CTRL)
/LEDs/DIM: R18.2, U1.6 (ADC1_CH6), U1.10 (GPO25)
/Microcontroller/5V: R3.2, R4.1, U1.26 (ADC2_CH0)
/Microcontroller/BAT: R5.2, R6.1, U1.8 (ADC1_CH4)
/Microcontroller/BTN: C5.2, R7.1, S1.1, S1.2, U1.4 (GPIO36)
/Microcontroller/CS: U1.23 (HSPIM.CS(PULL_UP+PWM)), U2.12 (CS)
/Microcontroller/EN: D1.6 (CH4), J1.7 (S:EN), R2.1, U1.3 (EN)
/Microcontroller/INT1: U1.28 (GPI17), U2.4 (INT1)
/Microcontroller/INT2: U1.24 (GPI2(PULL_DOWN)), U2.9 (INT2)
/Microcontroller/IO0: D1.1 (CH1), J1.1 (S:IO0), R1.1, U1.25 (GPI0(PULL_DOWN))
/Microcontroller/MISO: U1.14 (HSPIM.MISO(PULL_DOWN)), U2.1 (MISO)
/Microcontroller/MOSI: U1.12 (ADC2_CH7), U1.16 (HSPIM.MOSI), U2.14 (MOSI)
/Microcontroller/NEOPIXEL: U1.27 (GPO16), U3.3 (DIN)
/Microcontroller/RXD: D1.3 (CH2), J1.4 (S:RXD), U1.34 (U0RXD(PWM))
/Microcontroller/SCLK: U1.13 (HSPIM.SCLK(PWM)), U2.13 (SCL)
/Microcontroller/TXD: D1.4 (CH3), J1.5 (S:TXD), U1.35 (U0TXD(PWM))
GND: C1.1, C2.1, C3.1, C4.1, C5.1, C6.1, C7.1, C8.1, C9.1, C10.1, C11.1, C12.1, C13.1, C14.1, C15.1, D1.2 (VN), D3.2, D4.2, J1.8 (S:GND), J1.9 (GND), J2.A1 (GND), J2.A12 (GND), J2.B1 (GND), J2.B12 (GND), J2.SHELL (GND), J3.2 (-), R3.1, R5.1, R8.1, R9.1, R10.1, R11.1, R12.1, R14.1, R15.1, R17.1, S1.3, S1.4, U1.1 (GND), U1.15 (GND), U1.38 (GND), U1.39 (GND), U2.6 (GND), U2.7 (GND), U3.2 (VSS), U4.1 (GND), U5.2 (VSS), U6.2 (GND)
unnamed: D1.5 (VP), D2.2, J1.6 (S:3V3)
unnamed: C13.2, D5.1, D6.2 (A), D10.2 (A), R13.2
unnamed: D10.1 (K), D14.2 (A)
unnamed: D6.1 (K), D11.2 (A)
unnamed: D11.1 (K), D15.2 (A)
unnamed: D7.1 (K), D12.2 (A)
unnamed: D12.1 (K), D16.2 (A)
unnamed: D8.1 (K), D13.2 (A)
unnamed: D13.1 (K), D17.2 (A)
unnamed: D7.2 (A), D14.1 (K)
unnamed: D8.2 (A), D15.1 (K)
unnamed: D9.2 (A), D16.1 (K)
unnamed: D9.1 (K), D17.1 (K), R16.1, R17.2
unnamed: J1.2 (S:5V_IN), J1.3 (S:5V_OUT)
unnamed: J2.A5 (CC1), R11.2
unnamed: J2.B5 (CC2), R10.2
unnamed: R8.2, U2.3 (SCx)
unnamed: R9.2, U2.2 (SDx)
unnamed: R12.2, U5.5 (PROG)
unnamed: R16.2, R18.1, U6.3 (FB)
unnamed: R13.1, R15.2, U6.5 (OV)
unnamed: D5.2, L1.2, U6.1 (SW)
VBAT: C9.2, C11.2, C14.2, C15.2, D3.1, J3.1 (+), L1.1, R6.2, U4.3 (INPUT), U5.3 (VBAT), U6.6 (VIN)
