zandmd/esp32-projects/eda/programmer/programmer.kicad_pcb

## KiCad design eda/programmer/programmer.kicad_pcb (2023-10-10)

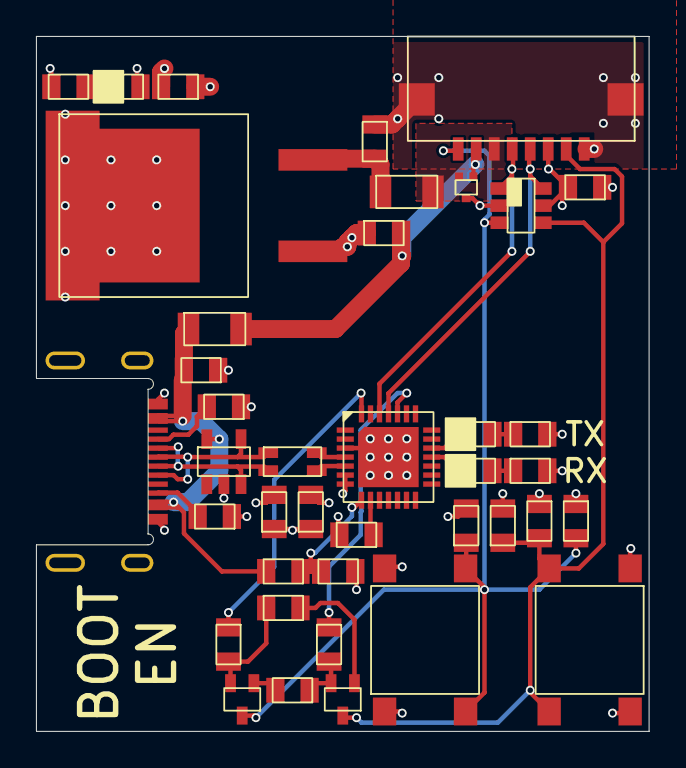
[picture p56: board programmer.kicad_pcb from above]

Board: 4 copper layers, 34.0 x 38.6 mm, 40 parts (0 on the bottom side), 29 nets.

Parts:
C1: 22 uF; PASSIVE-NPOL-0805
C2: 10 uF; PASSIVE-NPOL-0805
C3, C4, C5: 1 uF; PASSIVE-NPOL-0805
C6: 4.7 uF; PASSIVE-NPOL-0805
C7, C8, C9: 0.1 uF; PASSIVE-NPOL-0805
D1: RED; PASSIVE-POL-0805
D2: DF3A6.8LFV,L3F
D3: CM1293A-04SO
D4: YELLOW; PASSIVE-POL-0805
D5: 824011
D6: ORANGE; PASSIVE-POL-0805
F1, F2: 3 A; PASSIVE-NPOL-1206
J1: CF25081D0R0-10-NH
J2: USB4520-03-0-A
Q1, Q2: BSS816NWH6327XTSA1
R1, R3, R4: 330; PASSIVE-NPOL-0805
R2, R5: 5.1k; PASSIVE-NPOL-0805
R6, R7: 100k; PASSIVE-NPOL-0805
R8, R11, R14: 10k; PASSIVE-NPOL-0805
R9: 22k; PASSIVE-NPOL-0805
R10: 47k; PASSIVE-NPOL-0805
R12, R13: 100; PASSIVE-NPOL-0805
S1, S2: PTS645SM43SMTR92 LFS
T1: 744232090
U1: AZ1084CS2-3.3TRE1
U2: CP2102N-A02-GQFN28

Connections:
+3V3: C1.2, C3.2, C6.2, C7.2, D1.2, D3.5 (VP), J1.3 (M:3V3), R3.2, R4.2, R6.2, R7.2, R8.2, U1.2 (OUTPUT), U2.6 (VDD), U2.7 (VREGIN)
+5V: C4.2, D2.1 (K1), F2.2, J1.7 (M:5V_OUT)
/Interface/EN: C8.2, D3.4 (CH3), J1.2 (M:EN), Q2.3 (D), R7.1, S2.3, S2.4
/Interface/IO0: C9.2, D3.3 (CH2), J1.8 (M:IO0), Q1.3 (D), R6.1, S1.3, S1.4
/Interface/RXD: D3.6 (CH4), J1.4 (M:TXD), U2.25 (RXD)
/Interface/TXD: D3.1 (CH1), J1.5 (M:RXD), U2.26 (TXD)
/Reset Logic/~DTR: R12.1, U2.28 (~DTR)
/Reset Logic/~RTS: R13.1, U2.24 (~RTS)
/UART/D+: T1.2, U2.4 (D+)
/UART/D-: T1.3, U2.5 (D-)
GND: C1.1, C2.1, C3.1, C4.1, C5.1, C6.1, C7.1, C8.1, C9.1, D2.3 (A), D3.2 (VN), D5.2 (GND), J1.1 (M:GND), J1.9 (GND), J2.A1 (GND), J2.A12 (GND), J2.B1 (GND), J2.B12 (GND), J2.SHELL (GND), R1.1, R2.1, R5.1, R10.1, S1.1, S1.2, S2.1, S2.2, U1.1 (GND), U2.3 (GND), U2.29 (GND)
unnamed: D1.1, R1.2
unnamed: D2.2 (K2), F1.2, J1.6 (M:5V_IN)
unnamed: D4.2 (A), R3.1
unnamed: D4.1 (K), U2.19 (~TXT)
unnamed: D5.3 (IO1), J2.A7 (DN1), J2.B7 (DN1), T1.4
unnamed: D5.4 (IO2), J2.A6 (DP1), J2.B6 (DP1), T1.1
unnamed: D6.2 (A), R4.1
unnamed: D6.1 (K), U2.18 (~RXT)
unnamed: J2.A5 (CC1), R2.2
unnamed: J2.B5 (CC2), R5.2
unnamed: Q1.1 (G), R14.2
unnamed: Q1.2 (S), R11.1, R12.2
unnamed: Q2.1 (G), R11.2
unnamed: Q2.2 (S), R13.2, R14.1
unnamed: C2.2, F1.1, U1.3 (INPUT)
unnamed: R9.1, R10.2, U2.8 (VBUS)
unnamed: R8.1, U2.9 (~RST)
VBUS: C5.2, D5.5 (VDD), F2.1, J2.A4 (VBUS), J2.A9 (VBUS), J2.B4 (VBUS), J2.B9 (VBUS), R9.2
