zandmd/esp32-projects/eda/programmer-teckin/programmer-teckin.kicad_pcb

## KiCad design eda/programmer-teckin/programmer-teckin.kicad_pcb (2023-10-10)

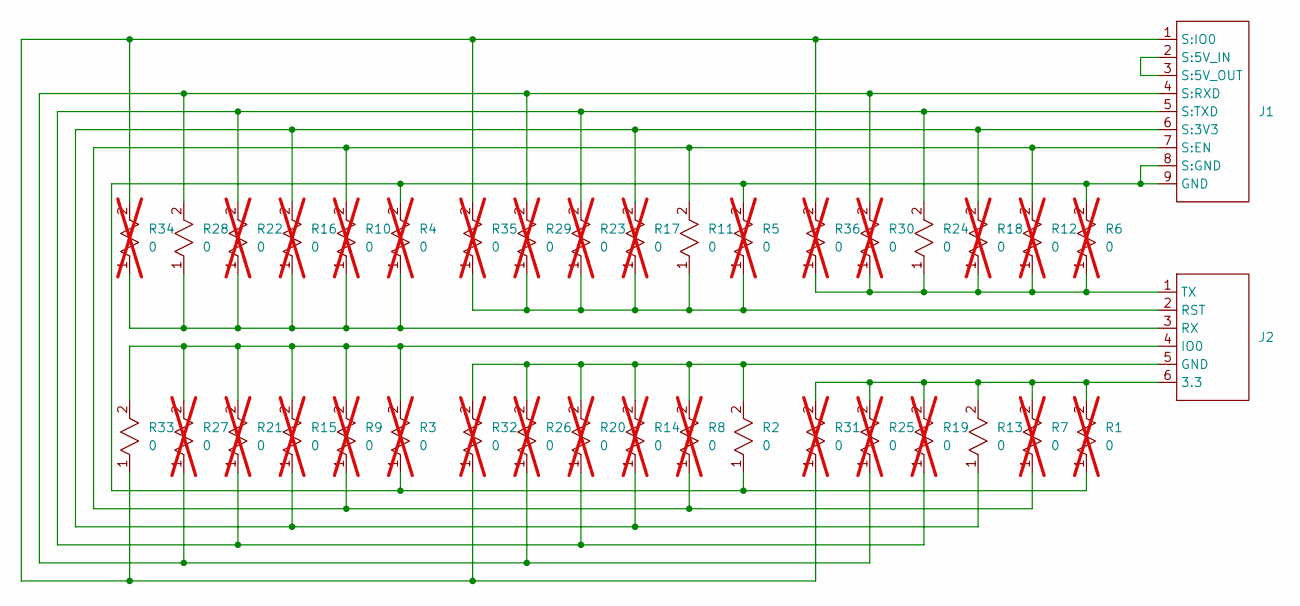
[picture p57: schematic programmer-teckin.kicad_sch]

Parts:
J1: CF25081D0R0-10-NH
J2: PH2-06-UA
R1, R3, R4, R5, R6, R7, R8, R9, R10, R12, R14, R15, R16, R17, R18, R19, R20, R21, R22, R23, R25, R26, R27, R29, R30, R31, R32, R34, R35, R36: 0; PASSIVE-NPOL-0805; not fitted
R2, R11, R13, R24, R28, R33: 0; PASSIVE-NPOL-0805

Connections:
unnamed: J1.8 (S:GND), J1.9 (GND), R1.1, R2.1, R3.1, R4.2, R5.2, R6.2
unnamed: J1.1 (S:IO0), R31.1, R32.1, R33.1, R34.2, R35.2, R36.2
unnamed: J1.2 (S:5V_IN), J1.3 (S:5V_OUT)
unnamed: J1.4 (S:RXD), R25.1, R26.1, R27.1, R28.2, R29.2, R30.2
unnamed: J1.5 (S:TXD), R19.1, R20.1, R21.1, R22.2, R23.2, R24.2
unnamed: J1.6 (S:3V3), R13.1, R14.1, R15.1, R16.2, R17.2, R18.2
unnamed: J1.7 (S:EN), R7.1, R8.1, R9.1, R10.2, R11.2, R12.2
unnamed: J2.1 (TX), R6.1, R12.1, R18.1, R24.1, R30.1, R36.1
unnamed: J2.2 (RST), R5.1, R11.1, R17.1, R23.1, R29.1, R35.1
unnamed: J2.3 (RX), R4.1, R10.1, R16.1, R22.1, R28.1, R34.1
unnamed: J2.4 (IO0), R3.2, R9.2, R15.2, R21.2, R27.2, R33.2
unnamed: J2.5 (GND), R2.2, R8.2, R14.2, R20.2, R26.2, R32.2
unnamed: J2.6 (3.3), R1.2, R7.2, R13.2, R19.2, R25.2, R31.2

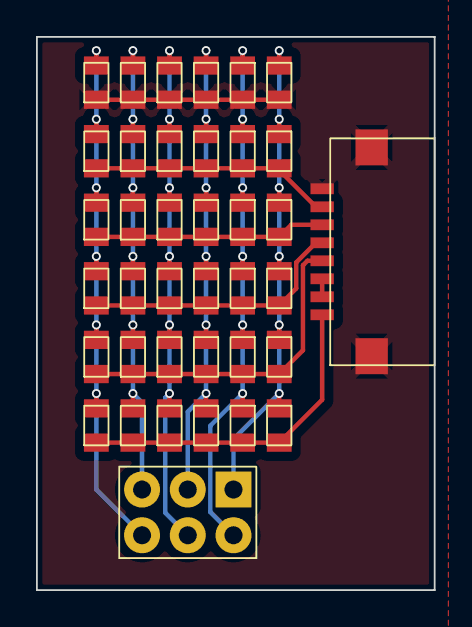
[picture p58: board programmer-teckin.kicad_pcb from above]

Board: 2 copper layers, 22.1 x 30.7 mm, 38 parts (0 on the bottom side), 13 nets.
