zandmd/esp32-projects/eda/pinewood-derby-car/pinewood-derby-car.kicad_pcb

## KiCad design eda/pinewood-derby-car/pinewood-derby-car.kicad_pcb (2023-10-10)

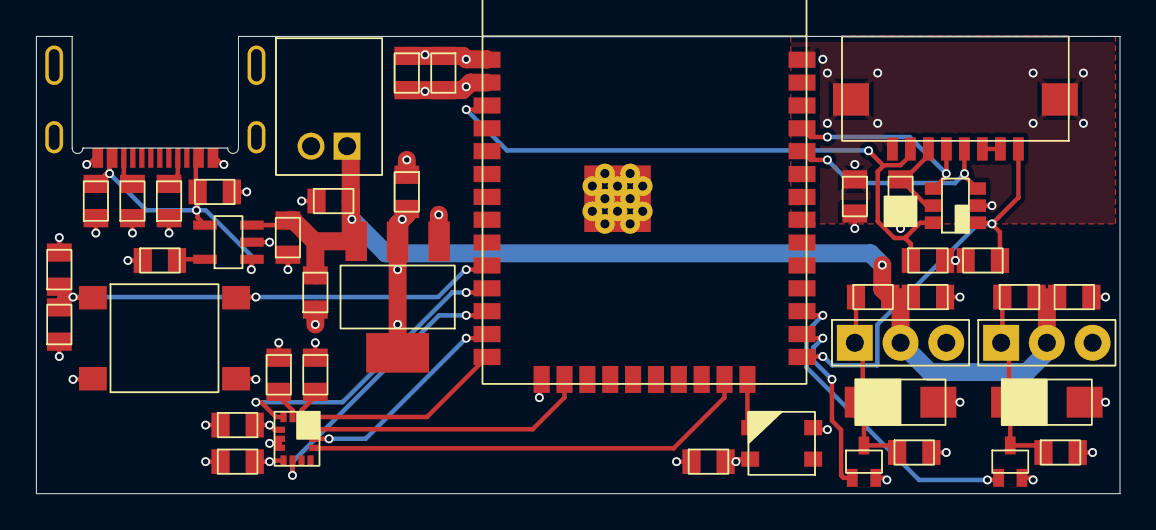
[picture p59: board pinewood-derby-car.kicad_pcb from above]

Board: 4 copper layers, 60.2 x 25.4 mm, 44 parts (0 on the bottom side), 27 nets.

Parts:
C1, C4: 22 uF; PASSIVE-NPOL-0805
C2, C12, C13, C14, C15: 0.1 uF; PASSIVE-NPOL-0805
C3, C5, C6, C7, C8, C10, C11: 1 uF; PASSIVE-NPOL-0805
C9: 10 uF; PASSIVE-NPOL-0805
D1: PASSIVE-POL-0805
D2: CM1293A-04SO
D3, D4: SMAJ5.0A
J1: USB4520-03-0-A
J2: CF25081D0R0-10-NH
J3: S2B-PH-K-S
J4, J5: PH1-03-UA
Q1, Q2: BSS816NWH6327XTSA1
R1, R2: 5.1k; PASSIVE-NPOL-0805
R3: 2.7k; PASSIVE-NPOL-0805
R4, R5, R6, R7, R8, R9, R10, R11, R12: 10k; PASSIVE-NPOL-0805
S1: PTS645SM43SMTR92 LFS
U1: ESP32-WROOM-32E-N4
U2: MCP73812T-420I/OT; MCP73812T-420IOT
U3: AZ1117IH-3.3TRG1
U4: LSM6DSOTR
U5: 2659

Connections:
+3V3: C1.2, C2.2, C4.2, C5.2, C13.2, C14.2, C15.2, D1.1, R4.2, R5.2, R6.2, R11.2, R12.2, U1.2 (3V3), U3.2 (OUTPUT), U4.5 (VDDIO), U4.8 (VDD), U5.4 (VDD)
+5V: C3.2, C6.2, J1.A4 (VBUS), J1.A9 (VBUS), J1.B4 (VBUS), J1.B9 (VBUS), U2.1 (CE), U2.4 (VDD)
/Channel 0/IN: Q1.1 (G), U1.26 (GPO4)
/Channel 1/IN: Q2.1 (G), U1.27 (GPO16)
/Microcontroller/BTN: C12.2, R6.1, S1.1, S1.2, U1.10 (GPI25)
/Microcontroller/CS: U1.23 (HSPIM.CS(PULL_UP+PWM)), U4.12 (CS)
/Microcontroller/EN: D2.6 (CH4), J2.7 (S:EN), R4.1, U1.3 (EN)
/Microcontroller/INT1: U1.11 (GPI26), U4.4 (INT1)
/Microcontroller/INT2: U1.12 (GPI27), U4.9 (INT2)
/Microcontroller/IO0: D2.1 (CH1), J2.1 (S:IO0), R5.1, U1.25 (GPI0(PULL_DOWN))
/Microcontroller/LED: U1.24 (GPO2(PULL_DOWN)), U5.3 (DIN)
/Microcontroller/MISO: U1.14 (HSPIM.MISO(PULL_DOWN)), U4.1 (MISO)
/Microcontroller/MOSI: U1.16 (HSPIM.MOSI), U4.14 (MOSI)
/Microcontroller/RXD: D2.3 (CH2), J2.4 (S:RXD), U1.34 (U0RXD(PWM))
/Microcontroller/SCLK: U1.13 (HSPIM.SCLK(PWM)), U4.13 (SCL)
/Microcontroller/TXD: D2.4 (CH3), J2.5 (S:TXD), U1.35 (U0TXD(PWM))
GND: C1.1, C2.1, C3.1, C4.1, C5.1, C6.1, C7.1, C8.1, C9.1, C10.1, C11.1, C12.1, C13.1, C14.1, C15.1, D2.2 (VN), D3.2, D4.2, J1.A1 (GND), J1.A12 (GND), J1.B1 (GND), J1.B12 (GND), J1.SHELL (GND), J2.8 (S:GND), J2.9 (GND), J3.2 (-), J4.3 (-), J5.3 (-), Q1.2 (S), Q2.2 (S), R1.1, R2.1, R3.1, R9.1, R10.1, S1.3, S1.4, U1.1 (GND), U1.15 (GND), U1.38 (GND), U1.39 (GND), U2.2 (VSS), U3.1 (GND), U4.6 (GND), U4.7 (GND), U5.2 (VSS)
unnamed: D1.2, D2.5 (VP), J2.6 (S:3V3)
unnamed: J1.A5 (CC1), R2.2
unnamed: J1.B5 (CC2), R1.2
unnamed: J2.2 (S:5V_IN), J2.3 (S:5V_OUT)
unnamed: D3.1, J4.1 (S), Q1.3 (D), R7.1, R11.1
unnamed: D4.1, J5.1 (S), Q2.3 (D), R8.1, R12.1
unnamed: R3.2, U2.5 (PROG)
unnamed: R9.2, U4.3 (SCx)
unnamed: R10.2, U4.2 (SDx)
VBAT: C7.2, C8.2, C9.2, C10.2, C11.2, J3.1 (+), J4.2 (+), J5.2 (+), R7.2, R8.2, U2.3 (VBAT), U3.3 (INPUT)
