zandmd/esp32-projects/firmware/disc-charger/components/bsp/include/zandmd/bsp/leds.hpp

#ifndef ZANDMD_BSP_LEDS_HPP
#define ZANDMD_BSP_LEDS_HPP

#include <stdint.h>

namespace zandmd {
    namespace bsp {
        class leds {
            public:
                leds() noexcept;

                void off() noexcept;
                void on(float duty_cycle) noexcept;

            private:
                static constexpr uint32_t frequency = 25000;
        };
    }
}

#endif
