zandmd/esp32-projects/firmware/disc-charger/components/bsp/include/zandmd/bsp/peripherals.hpp

#ifndef ZANDMD_BSP_PERIPHERALS_HPP
#define ZANDMD_BSP_PERIPHERALS_HPP

#include <zandmd/bsp/analog.hpp>
#include <zandmd/bsp/leds.hpp>
#include <zandmd/drivers/button.hpp>
#include <zandmd/drivers/lsm6dso.hpp>
#include <zandmd/drivers/ws2811.hpp>

namespace zandmd {
    namespace bsp {
        class peripherals {
            public:
                static drivers::button btn;
                static drivers::ws2811 status_led;
                static drivers::lsm6dso imu;
                static analog adc;
                static leds uv;

            private:
                peripherals() noexcept;
        };
    }
}

#endif
