zandmd/esp32-projects/firmware/rocket-launcher/components/bsp/src/bus.cpp

#include <zandmd/bsp/bus.hpp>
#include <zandmd/bsp/gpio.hpp>
#include <zandmd/bus/spi.hpp>
#include <zandmd/bus/spidev.hpp>

using namespace zandmd::bsp;
using namespace zandmd::bus;

spi bus::vspi(gpio::mosi, gpio::miso, gpio::sclk);
spidev bus::rfm(vspi[gpio::cs]);
