zandmd/esp32-projects/(commit log)

2023-10-10 Added EDA files
    [0297005.WXNV.step, 101-106.step, 2337019-1.stp, 2659.STEP, 302-S101.step, 3586KTR.step, 5684.step, 744232090.stp]
2023-10-12 Added WS2811 driver
2023-10-12 Added button driver
2023-10-13 Added gesture support to button driver
2023-10-16 Added SPI driver
2023-10-16 Added power_dump driver
2023-10-16 Added IMU driver
2023-11-04 enable RGB LED x1
2023-11-04 LEDs doing the disco
2023-11-04 working buttons
2023-11-07 working LEDs with buttons:
2023-11-09 Fixed build issue after refactored merge
    [main.cpp]
2023-11-09 Added LoRa module driver
2023-11-10 Implemented charges
2023-11-10 Added battery driver
2023-11-11 Fixed flickering LEDs
2023-11-11 Fixed crash after connecting charge
2023-11-11 Fixed LoRa transmission rate
    [pad_main.cpp]
2023-11-11 Added extra protection against fire button bounces
2023-11-11 Added more ADC failure handling
2023-11-11 Added watchdog timer
2023-11-11 Fixed various state machine issues
    [lco_main.cpp, pad_main.cpp, pad_to_lco.cpp]
2023-11-11 Fixed needing to reset radio after some weird boot conditions
    [lco_main.cpp, main.cpp, pad_main.cpp, pad_to_lco.cpp]
2023-12-09 Updated charge firing time
2023-12-13 Improved LED graphics framework
2023-12-14 Added workaround to disable Wi-Fi
    [main.cpp]
2023-12-16 Made the direction reverse occasionally
    [main.cpp]
2023-12-17 Switched lights to purple/white
2023-12-17 Created disc-charger firmware project
2023-12-19 Fixed gpio_isr_service with pin numbers >= 32
2023-12-19 Added button to disc-charger/hwtest
2023-12-19 Added neopixel to disc-charger/hwtest
2023-12-19 Added basic IMU driver to disc-charger/hwtest
2023-12-19 Added ADC driver to disc-charger/hwtest
2023-12-19 Added UV LEDs to disc-charger/hwtest
2023-12-23 Wrote disc charger app code
