zandmd/esp32-projects/(notices)

Notices in the files:
eda/3d/302-S101.step:
Copyright (C) 2017, kicad StepUp
This work is licensed under the [Creative Commons CC-BY-SA 4.0 License](https://creativecommons.org/licenses/by-sa/4.0/legalcode),
with the following exception:
To the extent that the creation of electronic designs that use 'Licensed Material' can be considered to be 'Adapted Material',
You are free to use the library data in your own projects without the obligation to share your project files under this or any other license agreement.
eda/3d/AZ1084CS2-3.3TRE1.step:
Copyright (C) 2023, Ray Benitez
This work is licensed under the
[Creative Commons CC-BY-SA 4.0 License](https://creativecommons.org/licenses/by-sa/4.0/legalcode),
project files under this or any other license agreement. However, if you wish to distribute
eda/3d/USB4520-03-0-A.stp:
author */ ('License CC BY-ND 4.0'),
